maximeprades/drawbox/README.md

# DrawBox

**Say it. Draw it. Print it.**

Your kid presses a big red button, says what they want to draw, and a coloring page prints out in seconds. No screen. No app. Just a button, a voice, and a printer.

<p align="center">
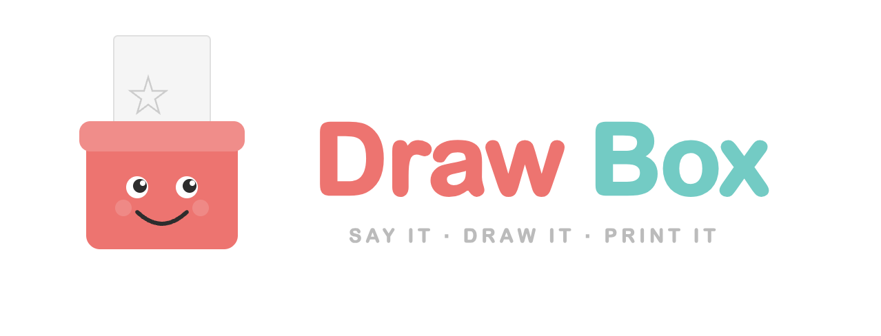
[picture p1: docs/drawbox.jpg]
DrawBox
  
</p>

Built with a Raspberry Pi 5, OpenAI (voice), and your choice of image model — all in a cardboard box with googly eyes.

**~3 hours to build | ~$135 in parts + printer | ~$0.02 per page**

---

## How It Works

```
Kid presses button → "I'm listening!"
    → Kid says "a happy dinosaur with flowers!"
    → Whisper transcribes speech
    → Safety filter checks against word blocklist
    → Image model generates coloring page
    → Pillow converts to clean B&W line art
    → "Here it comes!"
    → Brother laser printer prints it
    → "All done! Press the button when you want another one!"
```

Recording stops on its own about 1.5 seconds after the kid stops talking —
nobody stares at a listening box. While the image generates, DrawBox speaks a
personalized acknowledgment ("Ooh, a happy dinosaur with flowers! Drawing it
now!") and tells jokes to keep them entertained.

### Conversation Mode (beta)

Flip one setting and the boxes hold a real back-and-forth conversation
(Grok Voice Agent): the box chats, asks follow-ups, and prints when it has
heard enough. Drawings still pass the safety filter, spoken admin commands
stay deterministic, and the classic one-shot flow remains the fallback.
Costs ~$0.05/min of chat (xAI); off by default.

### Special Interactions

- **Hold button 5 seconds** — safe reboot ("Rebooting now! See you in a moment.")
- **Press while busy** — "Hold on, I'm still working on your picture!"
- **Blocked content** — "Hmm, I can't draw that. How about something fun like an animal or a rainbow?"
- **"Please" Mode** — optionally require kids to say "please" before each drawing

## Image Models

DrawBox generates images through Vercel AI Gateway. Pick any catalog model
from the dashboard Settings page (`image_model`). The default is
`google/gemini-3.1-flash-image`. Old aliases (`nano-banana`,
`gpt-image`) and ids the Gateway retired (`google/gemini-3.1-flash-image-preview`,
`openai/gpt-image-1`) still resolve to the matching catalog id.

## Parts

| Part | What It Does | ~Price |
|---|---|---|
| [PiShop Raspberry Pi 5 Budget Kit (4GB)](https://www.amazon.com/s?k=PiShop+Raspberry+Pi+5+Budget+Kit+4GB) | Pi + power supply + SD card + case | $75 |
| [Brother HL-L2405W](https://www.brother-usa.com/products/hll2405w) | B&W laser printer, USB | $100 |
| [EG STARTS 100mm Arcade Button](https://www.amazon.com/dp/B01LZMANZ7) | Big red dome button | $10 |
| [CHANGEEK USB Mic](https://www.amazon.com/dp/B0B4MJQ81C) | Gooseneck USB microphone | $10 |
| USB Sound Bar Speaker | USB-powered speaker (Pi 5 has no headphone jack) | $10 |
| [Pi 5 Active Cooler](https://www.amazon.com/s?k=Raspberry+Pi+5+Official+Active+Cooler) | Blower fan + heatsink (recommended) | $5 |
| [UGREEN USB-A to USB-B Cable](https://www.amazon.com/s?k=UGREEN+USB+A+to+USB+B+Printer+Cable) | Connects Pi to printer | $7 |
| [Female Spade Crimp Terminals](https://www.amazon.com/s?k=female+spade+crimp+terminal+4.8mm) | Connects wires to button's 4.8mm spade terminals | $8 |
| [5" Round Ventilation Grille](https://www.amazon.com/s?k=5+inch+round+ventilation+grille) | Speaker grille for the enclosure | $6 |
| Cardboard + hot glue | The enclosure | $5 |

**Also useful:** a [micro HDMI to HDMI adapter](https://www.amazon.com/s?k=UGREEN+Micro+HDMI+to+HDMI) for initial Pi setup with a monitor, and a [USB-C SD card reader](https://www.amazon.com/s?k=uni+SD+card+reader+USB+C) for flashing the SD card.

**Tools:** box cutter, metal ruler, pencil, hot glue gun, wire strippers (for spade terminals).

### Thermal Printer Option

No laser printer? DrawBox can also drive the [M5Stack ATOM Printer](https://docs.m5stack.com/en/guide/hobby_kit/atom_printer/usage) — a little 58mm receipt printer — or any ESC/POS serial thermal printer:

1. Flash `firmware/atom_printer_bridge_wifi` onto the ATOM once (see its README). It replaces the stock firmware with a print-head bridge that works over WiFi (the ATOM joins your network as `drawbox-atom.local`) or plain USB.
2. In the dashboard, switch **Settings → Printer** to the thermal option that matches: WiFi (host + port 9100) or USB serial.

Pages come out as receipt strips and take ~20-30 seconds at 9600 baud — the suspense is free. Keep the printer on its 12V power supply or prints come out faint. Smoke test without DrawBox:

### The Second Box: ESP32 Voice Button

DrawBox also has a pocket-sized sibling: a [Waveshare ESP32-S3-Touch-AMOLED-2.16](https://www.waveshare.com/esp32-s3-touch-amoled-2.16.htm) running `firmware/esp32_amoled_button/`. It shows a big animated emoji face — tap it, say what you want, and the same pipeline prints it. It speaks with the exact same voice, lines, and jokes as the big box (fetched from the dashboard, so editing scripts changes both), blinks while it waits, and mouths along while your kid talks. Setup, pairing, and build instructions live in its README.

```bash
python3 drawbox_escpos.py --port /dev/ttyUSB0
```

## Quick Start

### 1. Open the Build Guide

Open `drawbox-guide.html` in any browser. It's a single self-contained HTML file — 20 steps across 6 phases with embedded code, wiring diagrams, SVG cut templates, and troubleshooting.

### 2. Follow the 20 Steps

| Phase | Steps | What You Do |
|---|---|---|
| Getting Started | 1 | Verify all parts |
| Phase 1 — Pi Setup | 2-4 | Flash SD, SSH in, install dependencies |
| Phase 2 — Printer | 5-6 | Set up CUPS, test print |
| Phase 3 — Software | 7-10 | API key, create scripts, manual test, auto-start service |
| Phase 4 — Hardware | 11-13 | Wire button (GPIO 17), plug in mic & speaker, integration test |
| Phase 5 — Enclosure | 14-17 | Cut panels, build box, finishing touches |
| Phase 6 — Finishing Up | 18-20 | WiFi portability, cost cap, web dashboard |

### 3. Deploy the Web Dashboard

```bash
./deploy-web.sh
```

One command copies everything to the Pi, installs Flask + gunicorn, creates the systemd service, and starts the dashboard at `http://drawbox.local:5000`.

### 4. Run the Health Check

```bash
./check.sh
```

Verifies: internet, API keys, mic, speaker, printer, GPIO, Python deps, script correctness, services, and voice cache.

## What's In This Repo

| File | Description |
|---|---|
| `drawbox_core.py` | Shared logic — API keys, safety filter, image generation, post-processing, printing, analytics |
| `drawbox.py` | Main script — button listener, voice feedback, recording, transcription, joke-telling |
| `drawbox_web.py` | Flask web dashboard — generate from browser, live logs, settings, diagnostics |
| `drawbox-guide.html` | Complete interactive build guide (open in any browser) |
| `drawbox-simulator.html` | Browser simulator — test the full flow without a Pi (needs API keys) |
| `drawbox-hub.html` | Multi-Pi management hub — monitor and configure multiple DrawBoxes |
| `deploy-web.sh` | One-command deploy to Pi via SSH |
| `deploy-tunnel.sh` | One-command Cloudflare Tunnel setup for remote access |
| `check.sh` | Health check — verifies the entire Pi setup |
| `requirements.txt` | Python dependencies |
| `tests/` | pytest suite for the safety filter, settings, and Flask routes (runs on a Mac, no Pi needed: `pip install pytest && pytest tests/`) |

### Code Architecture

```
drawbox_core.py          ← shared: API keys, safety, generation, printing, logging
    ↑               ↑
drawbox.py          drawbox_web.py
(button + voice)    (Flask dashboard)
```

Both `drawbox.py` and `drawbox_web.py` import from `drawbox_core.py`, which centralizes all shared logic. This means bug fixes and model changes only need to happen in one place. See [ARCHITECTURE.md](ARCHITECTURE.md) for the full technical reference.

## Web Dashboard

The dashboard (`drawbox_web.py`) runs on the Pi at `http://drawbox.local:5000` and provides:

- **Overview** — service status, temperature, uptime, usage analytics, popular prompts
- **Generate & Print** — type a description, generate and print from any browser
- **Live Logs** — streaming service logs via SSE (`journalctl -u drawbox -f`)
- **Settings** — coloring prompt, image model, voice + speech-to-text providers, reply style, conversation mode, listening window, API keys
- **Scripts** — customize every voice line and joke DrawBox tells
- **"Please" Mode** — require kids to say "please" to get a drawing
- **Safety Filter** — toggle the word blocklist on/off
- **WiFi Management** — scan and connect to WiFi networks
- **Diagnostics** — printer status, audio devices, disk usage, temperature, error logs
- **Software Update** — pull latest code from GitHub and apply with one click
- **Service Control** — restart/stop/start DrawBox, reboot Pi

The dashboard uses gunicorn (2 workers, 4 threads) as a production WSGI server.

## Voice Lines

DrawBox talks to kids at every step. All lines are pre-generated as MP3s at startup and cached in `~/.drawbox/voice_cache/` for instant playback.

| When | What It Says |
|---|---|
| Ready | "Ready! Press the button and tell me what to draw!" |
| Listening | "I'm listening!" |
| Thinking | "Ooh, great idea!" / "That sounds awesome!" / "Cool!" (random) |
| Printing | "Here it comes!" |
| Done | "All done! Press the button when you want another one!" |
| Blocked | "Hmm, I can't draw that. How about something fun like an animal or a rainbow?" |
| Busy | "Hold on, I'm still working on your picture!" |
| Say please | "Oops! Don't forget to say please!" |
| Reboot | "Rebooting now! See you in a moment." (hold button 5s) |

All voice lines and jokes can be customized from the dashboard's Scripts page.

## Cost

Each coloring page is billed through Vercel AI Gateway (image + TTS + STT).
Set a spend limit on the Gateway dashboard.

## Safety

This is used by young children, so safety is built in at multiple layers:

1. **Word blocklist** — ~100 blocked words covering violence, sexual content, profanity, drugs, horror, and hate speech. Uses word-boundary matching so innocent words like "butterfly" or "grasshopper" are never blocked.
2. **Hardened prompt** — The image generation prompt explicitly instructs safe-only output regardless of what the child says.
3. **Friendly rejection** — "Hmm, I can't draw that. How about something fun like an animal or a rainbow?"
4. **Safety toggle** — Admins can toggle the word filter from the dashboard. Even when off, the AI prompt still requires child-safe output.

## Remote Access (Optional)

Access your DrawBox from anywhere using a Cloudflare Tunnel — no open ports, no dynamic DNS, $0/month on Cloudflare's free tier.

```bash
./deploy-tunnel.sh pi@drawbox.local mybox yourdomain.com
```

This creates:
- `https://mybox.yourdomain.com` — web dashboard (protected by Cloudflare Access)
- `https://mybox-ssh.yourdomain.com` — browser-based SSH terminal

**Prerequisites:** [cloudflared CLI](https://developers.cloudflare.com/cloudflare-one/connections/connect-networks/downloads/) installed on your Mac, logged in (`cloudflared tunnel login`), and a domain on Cloudflare.

After deploying, set up [Cloudflare Access](https://one.dash.cloudflare.com) to protect your tunnel with email OTP or another identity provider.

### Hub Page

`drawbox-hub.html` is a standalone page for monitoring multiple DrawBox Pis from one place. Open it locally or host it on Cloudflare Pages. It shows each Pi's status, temperature, uptime, and lets you toggle settings remotely.

## Troubleshooting

| Problem | Fix |
|---|-----|
| Printer not detected | `lsusb`, try different USB port |
| Mic not recording | `arecord -l` to list devices, check `~/.asoundrc` |
| Says "I didn't catch that" on every press | `journalctl -u drawbox -e`. `no usable input devices found` means the Pi sees no mic: check the cable. Each take logs `recorded …s (peak …)`; speech should peak near 0.15. Far lower means the mic gain is down: see [PI-SETUP step 10](PI-SETUP.md#10-set-the-mic-gain-one-time) |
| Drawing is made but nothing prints | **Settings → Printer Type**: the USB Brother needs **Laser / inkjet (CUPS)**. **M5Stack ATOM thermal — WiFi** works only while the ATOM bridge answers at `drawbox-atom.local` (green LED). `lpstat -p drawbox-printer` says `disabled`: CUPS paused the queue after a job failed while the printer was off. The next press re-enables it; `sudo cupsenable drawbox-printer` does it by hand |
| Says "Drawing it now!" then goes quiet | The image request is stuck. After 100 s it gives up and says "Oops". `journalctl -u drawbox -e` shows the Gateway error |
| No speaker sound | `aplay -l`, check `~/.asoundrc` card numbers |
| Button no response | Test with: `python3 -c "from gpiozero import Button; b=Button(17); print('pressed' if b.is_pressed else 'open')"` |
| Images too dark | Lower threshold from 180 to 150 in `drawbox_core.py` |
| Service won't start | `journalctl -u drawbox -e` — usually wrong API key |
| Dashboard not loading | `sudo systemctl status drawbox-web` |
| Tunnel not connecting | `sudo systemctl status cloudflared` and check `/etc/cloudflared/config.yml` |
| Need to reboot | Hold the big red button for 5 seconds |

## Pi 5 Gotchas

These are already handled in the guide, but good to know:

- **No headphone jack** — must use USB speaker
- **RPi.GPIO doesn't work** — use `gpiozero` instead (Pi 5 uses the RP1 I/O chip)
- **USB mic only supports 44100Hz** — not 16000Hz
- **GPIO chip is `gpiochip4`** — not gpiochip0 like older Pis (`gpiozero` handles this automatically)
- **USB devices shift card numbers** — if plugged into different ports, verify with `aplay -l` and `arecord -l`

## Contributing

See [CONTRIBUTING.md](CONTRIBUTING.md). Bug fixes, build guide improvements, and photos of your build are all welcome.

## License

[MIT](LICENSE)

---

## Photos

<p align="center">
DrawBox — front view with button, mic, and label
  
DrawBox — giant googly eyes
  
  
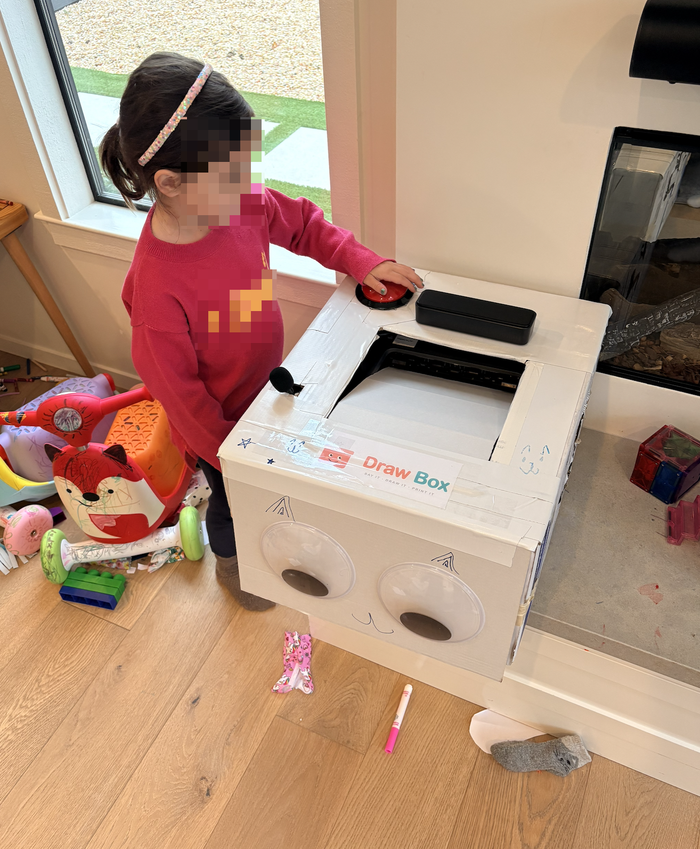
[picture p4: docs/1.jpeg]
Kid using DrawBox
  
</p>

---

Built for my kids. Now yours can have one too.
