maximeprades/drawbox/firmware/esp32_amoled_button/README.md

# DrawBox voice button (ESP32-S3 AMOLED)

A one-button DrawBox remote for the Waveshare **ESP32-S3-Touch-AMOLED-2.16**
(480×480 touch AMOLED, dual mics). Tap the big button, say what you want
("draw me a dinosaur"), and the page prints. The box records a 16 kHz WAV
and POSTs it to the Pi dashboard's `/api/voice/generate`; Whisper, the
safety filter, image generation, and printing all stay on the Pi.

With the dashboard's **conversation mode** on, a tap opens a live Grok
Voice Agent session instead (see [Conversation mode](#conversation-mode)):
the box streams the mics to the Vercel AI Gateway, plays the agent's
voice back, and the agent decides when you are done talking.

The screen is a big emoji buddy rendered with LVGL 8.4: it blinks and
glances around while idle, goes wide-eyed with its mouth moving to your
voice while listening (progress ring, rippling sound waves), naps under
a spinner while the Pi draws, and shows a joyful or deadpan face with
the transcript for the result. The face itself is pre-rendered on the
host by `gen_face_assets.py` (Pillow, 3x supersampled) into anti-aliased
bitmap frames baked into flash — nothing hand-drawn at runtime, so there
are no vector artifacts. `build.sh` regenerates `face_assets.h` when the
generator changes; the header is gitignored (4+ MB of hex).

## Setup

1. Copy `wifi_credentials.h.example` to `wifi_credentials.h` and fill in
   WiFi (2.4 GHz only), the DrawBox host, and a device token. The file is
   gitignored — never commit it.
2. Mint the token (physical route: press the arcade button, say
   "authorize"; or over SSH):

```bash
CODE=$(ssh pi@drawbox.local "cd /home/pi && python3 -c \
    'import drawbox_core; print(drawbox_core.open_pairing_window())'")
curl -X POST http://drawbox.local:5000/api/pair \
    -H 'Content-Type: application/json' \
    -d "{\"code\":\"$CODE\",\"name\":\"ESP32 voice button\"}"
```

3. Build and flash (needs `arduino-cli` with the `esp32:esp32` core):

```bash
./build.sh flash /dev/cu.usbmodemXXXX
```

`build.sh` fetches the display/touch/sensor/LVGL libraries from
Waveshare's own board repo, pinned to a known commit, into the gitignored
`.libs/`, then overlays our `lv_conf.h` (vendor config plus
`LV_USE_SNAPSHOT` for the screenshot hook). Asset generation needs
`python3` with Pillow. The ES7210 mic driver is vendored here (Espressif
MIT), with one behavioral change from the vendor example: gain goes to
MIC1/MIC2 — the board's real microphones per the schematic — not the
MIC3/4 echo-cancellation loopback the example boosts. With the example's
gains the recordings are silence.

## Serial test hooks

The native USB port doubles as a console at 115200:

- `t` — simulate a button press (full record → upload → result cycle, or
  a conversation session when the mode is on)
- `d` — dump the last recording as base64 WAV between marker lines
- `p` — dump a screenshot of the live UI as base64 RGB565 (little-endian)
- `b` — speaker loopback self-test (plays a tone, reports the mic peak)
- `s` — one-line status (state, WiFi, IP, heap, PSRAM, last WAV size,
  version, volume, brightness, conversation mode); also works mid-session
- `x` — end the running conversation session (same as the long press)
- `w` — conversation-mode heap spike: opens a TLS websocket to the Vercel
  AI Gateway realtime route next to the live UI and prints heap at each
  step (see `realtime_spike.h`). A 401 "Invalid client secret" after
  "wss connected" is the expected answer to the probe's bogus token.

A full remote test from the Mac, no hands needed:

```bash
(sleep 3 && say "draw me a dinosaur") & \
    python3 dbx_serial.py /dev/cu.usbmodemXXXX 45 t 1
```

## Sound

The onboard ES8311 codec drives the little speaker on the same I2S bus
as the mics (full duplex). After WiFi comes up, the box fetches the
dashboard voice catalog from `GET /api/voice/lines` and prefetches each
line as 16 kHz mono WAV from `GET /api/voice/line?key=&i=`. Clips live
in PSRAM. Each heartbeat reply carries the server's voice cache hash;
when the scripts or the TTS voice change in the dashboard, the box drops
its cache and refetches within a minute. The spoken lines and jokes are
the same ones the Pi arcade box uses, same voice included.

State changes play the matching line (`ready`, `listening`, `thinking`,
`printing`, or the `voice_key` from `/api/voice/generate`). While the
generate request is in flight, the box tells one joke after about two
seconds if the catalog has any. Synthesized chirps stay as the fallback
when a line is missing from the cache.

The listen line finishes before the mic opens, so recordings never
contain it. Upstream quirk worth knowing: the DAC power-up hides inside
`es8311_microphone_config`, so that call is required even though we
never use the ES8311's own mic path.

## Conversation mode

`realtime_client.h` is the ESP32 half of DrawBox conversation mode — the
same live Grok Voice Agent session the Pi runs in `drawbox_realtime.py`,
with the same policy, so both boxes behave alike:

1. Each heartbeat reply carries `conversation_mode`. When it is on, a tap
   POSTs `/api/realtime/token` and gets back the Gateway WSS URL, a
   ready-made `Sec-WebSocket-Protocol` header holding a 5-minute client
   secret, and the shared session config (instructions, voice, the
   `draw_coloring_page` tool, server VAD). The long-lived Gateway key
   never reaches the box.
2. The box opens the socket (TLS pinned to the Let's Encrypt roots in
   `gateway_ca.h`), sends `session-update`, and streams the mics as
   `input-audio-append` events: 16 kHz capture, louder mic slot kept,
   resampled to the agent's 24 kHz, base64, one event per 60 ms.
3. `audio-delta` events come back as 24 kHz PCM, get resampled to 16 kHz
   and queued in a PSRAM ring that the loop drains into the I2S DMA
   without blocking. The mouth moves with the agent's voice; the eyes go
   wide while the kid talks (`speech-started`).
4. Every `input-transcription-completed` goes to `POST /api/agent/intercept`
   (admin commands and blocklist, on the Pi). The agent's streamed
   transcript goes to `POST /api/agent/moderate` at most once a second
   and once more at `response-done`. A hit cancels the response, drops
   the queued audio, speaks the server's line (dynamic clip by `ack_key`,
   else the cached `voice_key`), and counts a strike; two strikes end the
   session.
5. `function-call-arguments-done` for `draw_coloring_page` is forwarded
   to `POST /api/agent/draw` (the gated pipeline; generation runs on the
   Pi) and the reply goes back as a `function-call-output` item followed
   by `response-create`.
6. The session ends after 45 s without kid speech, at the server's
   `max_session_s` cap, on two strikes, on a long press ("hold to stop"),
   or when the socket drops (the box then speaks the error line). If no
   session ever got configured — mode just switched off, Pi unreachable,
   Gateway refused, config rejected — the tap falls back to the one-shot
   record → upload flow, exactly like the Pi.

No barge-in: speaker and mics share one small box with no echo
cancellation, so mic frames are dropped while the agent's audio plays
(and for 700 ms after — the TX DMA holds ~380 ms). Talk when it stops.

## Behavior notes

- Recording stops early ~1.5 s after the kid stops talking (peak-based
  VAD, same thresholds as the Pi box); the dashboard's `record_seconds`
  setting is the ceiling (fetched once at boot, then refreshed on each
  heartbeat; defaults to 8 s if the first fetch fails).
- Since v1.6.0 the upload uses the two-phase ack flow: the server answers
  as soon as the transcript clears the gates with a personalized ack clip
  (played immediately), then the box long-polls `/api/voice/result` for
  the outcome, telling a joke while it waits. Old servers (no `job` field)
  are parsed exactly like the legacy blocking flow.
- Every 60 s the box POSTs a heartbeat to `/api/device/heartbeat`
  (`version`, WiFi RSSI, heap, PSRAM, voice-cache state). The dashboard
  Devices panel shows that status. The reply carries the live knobs
  (volume, brightness, `record_seconds`, `conversation_mode`, voice cache
  hash); a conversation session keeps beating every minute too.
- Speaker volume and screen brightness follow Settings → ESP32 Box. Each
  heartbeat applies the live values.
- Both mics are captured; the louder channel is kept, so covering one mic
  doesn't mute the box.
- Responses show the dashboard's own script lines ("Here it comes!",
  "Hmm, I can't draw that..."), so both boxes share one personality.
- One request at a time: if the other box is mid-generation the server
  answers busy and the screen says so.
