maximeprades/drawbox/ARCHITECTURE.md

# Architecture

Technical reference for DrawBox internals. Read this if you want to understand how the system works, contribute, or build your own variant.

## How It Works

1. Kid presses the big red arcade button
2. Speaker says "I'm listening!"
3. Kid says what they want ("a dinosaur riding a skateboard")
4. Whisper transcribes the audio
5. Safety filter checks for inappropriate content (~100-word blocklist)
6. GPT Image generates a coloring page (black & white line drawing)
7. Speaker announces "Here it comes!"
8. Brother laser printer prints it
9. Speaker says "All done! Press the button when you want another one!"

Special interactions:
- **Hold button 5 seconds** — safe reboot ("Rebooting now! See you in a moment.")
- **Press while busy** — "Hold on, I'm still working on your picture!"
- **Blocked content** — "Hmm, I can't draw that. How about something fun like an animal or a rainbow?"

## Hardware

| Component | Exact Model | Connection | Notes |
|---|---|---|---|
| **Computer** | Raspberry Pi 5 (4GB) | — | Running Raspberry Pi OS Bookworm (64-bit Lite) |
| **Printer** | Brother HL-L2405W | USB | Mono laser, set up driverless via IPP |
| **Button** | EG STARTS 100mm arcade button | GPIO 17 (Pin 11) + GND (Pin 9) | Microswitch has 4.8mm spade terminals |
| **Microphone** | CHANGEEK USB mic | USB (card 2, hw:2,0) | Only supports 44100Hz sample rate |
| **Speaker** | USB speaker | USB (card 3) | Configured as default via ~/.asoundrc |
| **Power** | Official Pi 5 27W USB-C PSU | USB-C | — |
| **Storage** | 32GB microSD | SD slot | — |

### Critical Hardware Notes

1. **RPi.GPIO does NOT work on Pi 5** — Must use `gpiozero`. The Pi 5 uses a different I/O chip (RP1) that RPi.GPIO doesn't support.
2. **USB mic sample rate is 44100Hz** — NOT 16000Hz. Using wrong rate causes `PortAudioError: Invalid sample rate`.
3. **GPIO chip on Pi 5 is `gpiochip4`** — Not gpiochip0 like older Pis. gpiozero handles this automatically.
4. **Button wiring**: COM → Pin 11 (GPIO 17), NO → Pin 9 (GND). The tab with the 90-degree bend is COM.
5. **No headphone jack on Pi 5** — Must use USB speaker or Bluetooth.
6. **USB devices shift card numbers** — If plugged into different ports, card numbers change. Verify with `aplay -l` and `arecord -l`.

### GPIO Pinout

```
Pin 9  (GND)     ← Button NO terminal
Pin 11 (GPIO 17) ← Button COM terminal
```

## Software Stack

| Layer | Technology | Notes |
|---|---|---|
| OS | Raspberry Pi OS Bookworm 64-bit Lite | Headless, no desktop |
| Language | Python 3 | System Python, no virtualenv |
| GPIO | gpiozero | NOT RPi.GPIO (incompatible with Pi 5) |
| AI - Image | Vercel AI Gateway | catalog id from `GATEWAY_IMAGE_CATALOG` |
| AI - Speech-to-Text | Vercel AI Gateway (`openai/whisper-1` or `spacexai/grok-stt`) | Selected by the `stt_provider` setting |
| AI - Text-to-Speech | Vercel AI Gateway (`openai/tts-1` or `spacexai/grok-tts`) | Selected by the `voice_provider` setting; gateway voice `alloy` is the default |
| AI - Conversation | Vercel AI Gateway realtime (`spacexai/grok-voice-think-fast-2.0`) | Opt-in `conversation_mode`; normalized AI SDK realtime events over `wss://ai-gateway.vercel.sh/v4/ai/realtime-model` |
| Audio Recording | sounddevice + soundfile | Via PortAudio/ALSA |
| Image Processing | Pillow (PIL) | Threshold + resize to Letter |
| Audio Playback | mpg123 | Plays cached .mp3 TTS files |
| Printing | CUPS (lp command) | Driverless IPP setup |
| Web Dashboard | Flask | `http://drawbox.local:5000` |
| Process Management | systemd | Two services: `drawbox.service` + `drawbox-web.service` |

### Python Dependencies

```
openai, Pillow, numpy, sounddevice, soundfile, gpiozero, flask, websockets
```

## Script Architecture (drawbox.py)

### Flow

```
main()
  └→ button.wait_for_press()
       ├→ [if held >= 5s] → voice.play("reboot") → sudo reboot
       ├→ [if is_busy] → voice.play("busy") → continue
       └→ [normal press]:
            └→ voice.play("listening")
            └→ record_audio()          # record_seconds setting (default 10s) at 44100Hz
            └→ transcribe()            # Whisper API
            └→ is_safe()               # Blocklist check
            └→ voice.play("thinking")  # Random variation (5 options)
            └→ generate_image()        # AI Gateway image model
            └→ voice.play("printing")
            └→ print_image()           # lp command to CUPS
            └→ voice.play("done")
```

### Key Design Decisions

1. **gpiozero Button** with `pull_up=True, bounce_time=0.1` — `wait_for_press()` blocks until button pressed, bounce_time prevents double-triggers
2. **Long-press reboot** — Polls `btn.is_pressed` in 0.1s increments; if held >= 5 seconds, plays "Rebooting now!" and runs `sudo reboot`
3. **VoiceFeedback class** — Pre-generates and caches all TTS lines as .mp3 at startup (`~/.drawbox/voice_cache/`). Uses MD5 hash of voice+text for deterministic filenames. 0.5s sleep before playback lets USB speaker wake up.
4. **if/elif/else chain** (not try/continue) — Avoids `continue` inside `try/finally` blocks which would skip `is_busy = False` reset.
5. **Walrus operator** for transcription: `elif not (text := transcribe(path)) or len(text.strip()) < 2`
6. **Safety blocklist** — Set of ~100 blocked words checked against transcription. Plus prompt engineering in COLORING_PROMPT.
7. **Image post-processing** — Convert to grayscale → threshold at 180 → resize to 1125x1125 → paste centered on 1275x1650 Letter canvas
8. **Busy guard** — `is_busy` flag prevents overlapping requests
9. **Minimum audio check** — Recordings shorter than 0.5s are discarded (silence/accidental press)

## Web Dashboard (drawbox_web.py)

Flask web app at `http://drawbox.local:5000`. Runs as a separate systemd service.

### Routes

| Route | Method | Purpose |
|---|---|---|
| `/` | GET | Dashboard (single-page, inline HTML) |
| `/guide` | GET | Serves drawbox-guide.html |
| `/simulator` | GET | Serves drawbox-simulator.html |
| `/api/generate` | POST | Safety check → generate image → print |
| `/api/voice/generate` | POST | Raw WAV body → STT → same gates/pipeline as `/api/generate`; responses carry a `voice_key` naming the script line to speak. With `X-DrawBox-Ack: 1` (firmware >= 1.6.0) it answers right after the gates with a personalized `ack_key` clip while generation continues server-side |
| `/api/voice/result` | GET | Long-poll the in-flight voice job (`?id=`) for the final outcome |
| `/api/voice/clip` | GET | One synthesized 16 kHz WAV by cache key (`?k=`) — ack and intercept clips |
| `/api/voice/lines` | GET | Voice-line manifest: variant counts per script key, joke count, cache hash |
| `/api/voice/line` | GET | One script line or joke (`?key=K&i=N`) as 16 kHz mono WAV, disk-cached beside the daemon's mp3 cache |
| `/api/realtime/token` | POST | Conversation mode: ephemeral xAI client secret + the shared session config |
| `/api/agent/draw` | POST | Conversation mode: execute the agent's gated draw tool call |
| `/api/agent/intercept` | POST | Conversation mode: run a transcript through the admin/blocklist interceptor |
| `/api/logs` | GET | SSE stream of journalctl |
| `/api/settings` | GET/POST | Read/write settings |
| `/api/diagnostics` | POST | Run allowlisted diagnostic commands |
| `/api/service/<action>` | POST | systemctl restart/stop/start |
| `/api/status` | GET | Service status, temperature, uptime |
| `/api/reboot` | POST | sudo reboot |

### Implementation Notes

- **Shared core** — Both scripts import from `drawbox_core.py` (API keys, safety, image generation, printing, logging)
- **No auth** — Home toy on local network
- **Diagnostics allowlist** — 14 commands, no arbitrary shell execution
- **Log streaming** — SSE via `journalctl -u drawbox -f`

## File Layout

### Development (Mac)

```
drawbox_core.py         # Shared logic (API keys, safety, generation, printing)
drawbox.py              # Main script (the brain)
drawbox_web.py          # Flask web dashboard
drawbox-guide.html      # 20-step interactive build guide
drawbox-simulator.html  # Browser-based simulator (no Pi needed)
deploy-web.sh           # One-command deploy to Pi
check.sh                # Health check script
requirements.txt        # Python dependencies
```

### Pi (/home/pi/)

```
~/drawbox_core.py         # Shared logic module
~/drawbox.py              # Main script (drawbox.service)
~/drawbox_web.py          # Web dashboard (drawbox-web.service)
~/drawbox-guide.html      # Served at /guide
~/drawbox-simulator.html  # Served at /simulator
~/check.sh                # Health check
~/.drawbox/voice_cache/   # Cached TTS audio (.mp3)
~/.drawbox/web_settings.json  # Dashboard settings
~/.asoundrc               # ALSA audio device config
```

### Systemd Services

```
/etc/systemd/system/drawbox.service      # Main script, auto-starts on boot
/etc/systemd/system/drawbox-web.service  # Dashboard, auto-starts on boot
/etc/sudoers.d/drawbox-web               # Passwordless systemctl for dashboard
```

## Configuration

### API Keys

DrawBox loads API keys with this precedence (first match wins per key):

1. `~/.drawbox/api_keys.json` field `ai_gateway`
   (mode 0600, managed from the dashboard)
2. Environment variable `AI_GATEWAY_API_KEY`

The OpenAI Python client talks to `https://ai-gateway.vercel.sh/v1` for
images. Speech, transcription, and conversation-mode realtime also go
through the AI Gateway (OpenAI or xAI models, one key). The dashboard
writes the JSON file; `deploy-web.sh` migrates an existing systemd
`AI_GATEWAY_API_KEY` into it on first run. New deployments don't need keys
in the service file at all.

### Optional Environment Variables

| Variable | Effect |
|---|---|
| `IMAGE_MODEL` | Default model — a gateway catalog id (see `GATEWAY_IMAGE_CATALOG`). Legacy aliases such as `nano-banana` rewrite to the matching catalog id. |
| `DRAWBOX_ALLOWED_ORIGINS` | Comma-separated CORS allowlist for the dashboard. Defaults cover `*.drawbox.pages.dev`. Accepts exact hosts or `*.domain.tld` patterns. |

### ALSA Audio (~/.asoundrc)

```
defaults.pcm.card 3
defaults.ctl.card 3
```

Card numbers depend on USB port order. Verify with `aplay -l` and `arecord -l`.

### Printer Setup

```bash
# Driverless IPP (recommended)
sudo lpadmin -p drawbox-printer -E \
    -v "ipp://Brother%20HL-L2405W%20(USB)._ipp._tcp.local/" \
    -m everywhere
sudo lpoptions -d drawbox-printer
```

For the M5Stack ATOM Printer (or any ESC/POS serial thermal printer), CUPS
is not involved. `print_image()` hands the page to `drawbox_escpos.py`,
which renders it to ESC/POS raster bytes and writes them to the printer.
The ATOM must be flashed once with the bridge sketch in
`firmware/atom_printer_bridge_wifi/` (see its README).

Two transports, chosen by `printer_type` in the dashboard Settings (stored
in `~/.drawbox/web_settings.json`): `escpos_tcp` prints over the network —
the flashed ATOM joins your WiFi, announces itself as `drawbox-atom.local`,
and accepts one raw TCP client on port 9100 (`tcp_host` / `tcp_port`) —
and `escpos_serial` prints over a USB cable (`serial_port` /
`serial_baud`). Same rendering path either way.

### ESP32 voice button (second box)

A standalone voice box on a Waveshare ESP32-S3-Touch-AMOLED-2.16
(`firmware/esp32_amoled_button/`). The screen is an animated emoji face
(LVGL + host-prerendered bitmaps); tapping it records 16 kHz WAV from the
onboard mics and POSTs it to the dashboard's `/api/voice/generate` with a
paired-device token. Transcription, safety, generation, and printing all
run on the Pi, so the firmware stays a thin record-and-upload client.

It speaks with the Pi box's exact personality: at boot it prefetches every
dashboard voice line (and jokes on demand) from `/api/voice/lines` +
`/api/voice/line` into PSRAM and plays them through its ES8311 codec at
the same moments the button daemon speaks — ready, listening, a thinking
variant, one joke while generating, and the `voice_key` line the server
names in each response. Editing scripts or the TTS voice in the dashboard
changes both boxes; the box re-fetches at boot and, via the cache hash in
each heartbeat reply, within a minute of an edit. Synthesized chirps
remain only as a fallback when a line is missing.

### Conversation mode (opt-in)

With the `conversation_mode` setting on, a press/tap starts a live Grok
Voice Agent session (`drawbox_realtime.py` on the Pi,
`firmware/esp32_amoled_button/realtime_client.h` on the ESP32). The session
config — voice, editable `agent_instructions`, server VAD, the
`draw_coloring_page` tool — is built once in
`drawbox_core.realtime_session_config()` so both boxes share one personality. The wire protocol is the AI SDK's normalized
realtime event set (`session-update`, `input-audio-append`, `audio-delta`,
`input-transcription-completed`, `function-call-arguments-done`, ...); the
Gateway translates to xAI server-side. Auth is a short-lived `vcst_`
client secret minted by `mint_realtime_client_secret()` (TTL 300 s) and
carried in the `Sec-WebSocket-Protocol` handshake as `ai-gateway-auth.<token>`
(`gateway_realtime_protocols()`), never as an `Authorization` header —
`POST /api/realtime/token` hands the ESP32 the URL, token, and protocol
list ready-made (plus `protocol_header`, the list pre-joined). Safety is
layered: the agent's tool calls run the full gates (`execute_draw_tool`),
and every input/output transcript passes the deterministic
`intercept_transcript` (exact-match admin commands, then the blocklist)
with response-kill on a hit; two strikes end the session. The Pi calls
those core functions directly; the ESP32 reaches the same code over
`POST /api/agent/intercept` (kid transcripts), `POST /api/agent/moderate`
(the agent's words — blocklist only, never the admin commands) and
`POST /api/agent/draw`, and learns whether the mode is on from the
`conversation_mode` flag in every heartbeat reply. The box has no echo
cancellation, so it mutes its mics while the agent's audio plays (no
barge-in); the Pi, with separate USB mic and speaker, streams
continuously. Sessions cost $0.08/min of audio (xAI's rate, passed through
by the Gateway; the Gateway itself also caps sessions at 25 min and idles
them out at 5), cap at 5 minutes client-side,
and any failure falls back to the one-shot flow. See the firmware README
for setup, build, and the serial test hooks.

## Known Issues

| Issue | Cause | Fix |
|---|---|---|
| SSH dies after reboot | Socket not enabled | `sudo systemctl enable ssh.service && sudo systemctl enable ssh.socket` |
| "GPIO busy" error | Previous process holds pin | `sudo killall python3` then restart service |
| `continue` in try/finally | `is_busy` flag stays stuck | Use if/elif/else chains instead (already fixed) |
| drawbox.local not resolving | mDNS issue | Use IP directly: `hostname -I` |
