maximeprades/drawbox/drawbox-guide.html

☰ Guide

# DrawBox Build Guide

Your kid presses a big red button, tells the box what they want to draw, and a coloring page prints out. Magic in a box.

~3 hrsTotal build

20Steps

$0.06Per page

Build Progress0 / 17

📦

## Parts Inventory

Confirm everything before you start

✓

Unbox & verify all parts

5 min▼

Lay everything out. Here's your exact kit:

🖥️ Raspberry Pi 5 (4GB)The brain. Runs the whole show.

✓ You have this

💾 Micro SD Card + USB-C PSUPi's hard drive + 27W power supply

✓ You have this

🖨️ Brother HL-L2405WB&W laser, USB + WiFi. 14"×14"×7.2"

✓ Ordered

🔴 EG STARTS 100mm Arcade ButtonBig red dome, LED, microswitch. 100mm diameter!

✓ Ordered

🎙️ C G CHANGEEK Gooseneck USB MicFlexible gooseneck, built-in sound card, USB-A

✓ Ordered

🔊 USB SpeakerUSB-powered, plug-and-play. No 3.5mm needed (Pi 5 has no headphone jack!)

✓ Ordered

🔌 USB-A to USB-B CableConnects Pi to printer (square end → printer)

✓ Ordered

📦 Golden State Art Cardboard (10pk)24×36" corrugated, one-side white. No wrapping needed!

✓ Ordered

⚠️

Jumper wires: The EG STARTS 100mm button usually comes with wires and a microswitch connector. Check the package. If it only has bare terminals, you need 2 female-to-female dupont jumper wires (~$3 on Amazon).

🔧

Tools needed: Box cutter, metal ruler, pencil, hot glue gun + sticks, something to trace the 100mm circle (coffee mug or compass).

🖥️

## Phase 1 — Raspberry Pi Setup

From sealed box to running computer

✓

Flash the SD card with Raspberry Pi OS

10 min▼

On your Mac or PC:

1. Download Raspberry Pi Imager from raspberrypi.com/software

2. Insert your micro SD card (use adapter if needed)

3. Open Imager and select:

settingsDevice: Raspberry Pi 5 OS: Raspberry Pi OS Lite (64-bit) → Under "Raspberry Pi OS (other)" → Lite version Storage: Your SD card

4. Click the gear icon ⚙️ (OS Customization) — this is the key step:

customization☑ Set hostname: drawbox ☑ Enable SSH: Use password authentication ☑ Set username: pi ☑ Set password: your-password-here ← remember this! ☑ Configure WiFi: SSID: your-wifi-name Password: your-wifi-password Country: US ☑ Set locale: Timezone: America/New_York Keyboard: us

5. Click Write. Wait 5-10 minutes.

💡

Setting WiFi + SSH here means you never need a monitor, keyboard, or mouse on the Pi. You'll control it entirely from your laptop. This is called "headless" setup.

▶️

Video guide: Search: Raspberry Pi Imager headless setup (https://www.youtube.com/results?search_query=raspberry+pi+imager+headless+setup+ssh+wifi) — watch someone walk through each screen.

✓

First boot & SSH into the Pi

5 min▼

Assemble:

1. Insert flashed SD card into Pi (bottom slot, push until click)

2. Plug USB-C power supply in

3. That's it — green LED flickers as it boots

⏳

Wait 60-90 seconds on first boot. It needs to expand filesystem, connect WiFi, start SSH.

Connect from your laptop terminal:

terminalssh pi@drawbox.local

Type yes for fingerprint, then your password.

If drawbox.local doesn't work:

terminal# Check your router's admin page for the Pi's IP # Or try: ping drawbox.local # Then: ssh pi@[IP_ADDRESS]

When you see pi@drawbox:~ $ — you're in! 🎉

💡

From now on, every command in this guide is typed into this SSH terminal.

⚠️

SSH may die after reboot. Pi OS sometimes only enables ssh.socket but not ssh.service. To make SSH reliable, run:
sudo systemctl enable ssh.socket && sudo systemctl enable ssh.service

✓

Install all software dependencies

10 min▼

Run these one at a time in SSH:

A — Update system:

bashsudo apt update && sudo apt upgrade -y

Takes 3-5 min. Let it run.

B — System packages:

bashsudo apt install -y cups printer-driver-brlaser python3-pip \ libportaudio2 libsndfile1 alsa-utils mpg123

C — Python packages:

bashpip3 install --break-system-packages \ openai gpiozero sounddevice soundfile numpy Pillow

ℹ️

What these do: cups = print system, printer-driver-brlaser = Brother driver, mpg123 = plays TTS audio, openai = GPT Image + Whisper + TTS API, gpiozero = button input, sounddevice = mic recording, Pillow = image processing

🖨️

## Phase 2 — Printer Setup

Brother HL-L2405W via USB

✓

Connect printer & configure CUPS

10 min▼

Physical setup:

1. Unbox Brother, remove all packing tape/inserts

2. Install toner cartridge (in box, wrapped in plastic)

3. Load Letter paper (8.5×11) in tray

4. Plug in power, turn on

5. USB-A end → Pi, USB-B end → back of printer

⚠️

Wait for printer to finish calibration (~30 sec). Ready light should be solid green.

Configure CUPS:

bash# Add user to printer admin group sudo usermod -aG lpadmin pi # Start print system sudo systemctl enable cups sudo systemctl start cups # Verify Pi sees printer via USB lsusb # Should show: "Brother Industries, Ltd" # List available printers lpinfo -v # Look for: direct usb://Brother/HL-L2405W...

Add the printer:

bash# Add using driverless (IPP Everywhere) — works on Pi OS Bookworm sudo lpadmin -p drawbox-printer -E \ -v "$(lpinfo -v 2>/dev/null | grep -i brother | head -1 | awk '{print $2}')" \ -m everywhere # If driverless fails, try brlaser driver: # sudo lpadmin -p drawbox-printer -E \ # -v "$(lpinfo -v | grep -i brother | head -1 | awk '{print $2}')" \ # -m drv:///brlaser.drv/brl2405w.ppd # Set as default sudo lpoptions -d drawbox-printer sudo cupsenable drawbox-printer sudo cupsaccept drawbox-printer

ℹ️

Printer sleep mode: The Brother HL-L2405W goes to sleep after a few minutes of inactivity. Print jobs queue up and will print automatically when the printer wakes — just takes a few extra seconds for the first print.

💡

Web UI option: Run sudo cupsctl --remote-admin, then open http://drawbox.local:631 in your browser → Administration → Add Printer.

▶️

Video guide: Search: Raspberry Pi CUPS USB printer setup (https://www.youtube.com/results?search_query=raspberry+pi+cups+usb+printer+setup)

✓

Send a test print

2 min▼

bashecho "DrawBox test - $(date)" | lp -d drawbox-printer lpstat -p -d

A page should print. If it does — printer is working! 🎉

🔧

Nothing printed? lpstat -p (is it listed?), lsusb (Brother showing?), try replugging USB, check sudo tail /var/log/cups/error_log

💻

## Phase 3 — Software

Speech → Image → Print pipeline

✓

Set up OpenAI API key

3 min▼

You likely have one already. If not: platform.openai.com → API Keys → Create new key → name it "DrawBox"

bash# Save to shell profile echo 'export OPENAI_API_KEY="sk-your-key-here"' >> ~/.bashrc source ~/.bashrc # Verify echo $OPENAI_API_KEY

💰

Cost: ~$0.04/image (GPT Image) + ~$0.006/min (Whisper) + ~$0.01 (TTS voice) = ~$0.06 per coloring page. $5 = ~80 pages.

✓

Create the DrawBox script

5 min▼

This is the entire app — one Python file:

bashnano ~/drawbox.py

Paste the script below. In nano: right-click to paste, Ctrl+O to save, Ctrl+X to exit.

✏️

Customize: Edit the coloring prompt below. Your changes will be included in the script.

Coloring Prompt — edit to customize Create a simple coloring page for children ages 3-8. This is used by YOUNG CHILDREN — output MUST be 100% child-safe. - Black and white LINE DRAWING only - Thick, clean outlines (3-4px stroke) - NO shading, NO gradients, NO filled/solid areas - NO gray — pure black lines on white - Simple shapes, minimal fine detail - Large open areas for coloring with crayons - Friendly, fun, cute, non-scary style - Centered, filling most of the space - Style: children's coloring book page - ONLY draw safe, wholesome subjects (animals, nature, vehicles, food, toys) - NEVER draw anything violent, scary, sexual, or inappropriate for a 5-year-old - If the request is ambiguous, default to the most innocent interpretation

Copy Prompt Reset Default

drawbox.py

#!/usr/bin/env python3
"""DrawBox — AI Coloring Page Printer for Kids

Hardware: Pi 5, Brother HL-L2405W (USB), EG STARTS 100mm button,
          CHANGEEK USB mic, USB speaker
"""

import os, time, tempfile, subprocess, random, hashlib, threading
import sounddevice as sd
import soundfile as sf
import numpy as np
from gpiozero import Button as GpioButton
from openai import OpenAI
from PIL import Image
import base64
from io import BytesIO
from pathlib import Path

# ── CONFIG ──────────────────────────────────────
OPENAI_API_KEY = os.environ.get("OPENAI_API_KEY")
BUTTON_PIN = 17
SAMPLE_RATE = 44100
PRINTER_NAME = "drawbox-printer"
RECORD_SECONDS = 10
REBOOT_HOLD_SEC = 5           # hold button 5s to reboot
TTS_VOICE = "nova"            # alloy, echo, fable, onyx, nova, shimmer
CACHE_DIR = Path.home() / ".drawbox" / "voice_cache"

# ── SAFETY BLOCKLIST ────────────────────────────
BLOCKED_WORDS = {
    "kill", "murder", "dead", "death", "die", "dying", "corpse",
    "blood", "bloody", "gore", "gory", "wound", "stab", "shoot",
    "gun", "guns", "rifle", "pistol", "shotgun", "weapon", "knife",
    "bomb", "explode", "explosion", "grenade", "missile", "nuke",
    "sex", "sexy", "sexual", "nude", "naked", "porn", "hentai",
    "penis", "dick", "cock", "vagina", "pussy", "boob", "breast",
    "nipple", "butt", "ass", "anus", "genital", "erotic", "orgasm",
    "fuck", "shit", "damn", "bitch", "bastard", "crap", "piss",
    "whore", "slut", "hooker", "prostitute", "stripper",
    "drug", "drugs", "cocaine", "heroin", "meth", "weed", "marijuana",
    "alcohol", "beer", "wine", "vodka", "drunk", "cigarette", "smoke",
    "devil", "satan", "demon", "hell", "torture", "horror", "zombie",
    "vampire", "skeleton", "skull", "coffin", "grave", "creepy",
    "scary", "nightmare", "terror", "evil", "wicked", "curse",
    "hate", "racist", "racism", "nazi", "hitler", "slavery", "slave",
    "suicide", "hanging", "noose", "drown", "poison", "overdose",
    "rape", "molest", "abuse", "kidnap", "assault", "victim",
    "war", "soldier", "army", "military", "combat", "battle",
    "thong", "lingerie", "bikini", "underwear",
    "pee", "fart", "vomit", "snot",
}

def is_safe(text):
    words = text.lower()
    return not any(w in words for w in BLOCKED_WORDS)

COLORING_PROMPT = """Create a simple coloring page for children ages 3-8.
This is used by YOUNG CHILDREN — output MUST be 100% child-safe.
- Black and white LINE DRAWING only
- Thick, clean outlines (3-4px stroke)
- NO shading, NO gradients, NO filled/solid areas
- NO gray — pure black lines on white
- Simple shapes, minimal fine detail
- Large open areas for coloring with crayons
- Friendly, fun, cute, non-scary style
- Centered, filling most of the space
- Style: children's coloring book page
- ONLY draw safe, wholesome subjects (animals, nature, vehicles, food, toys)
- NEVER draw anything violent, scary, sexual, or inappropriate for a 5-year-old
- If the request is ambiguous, default to the most innocent interpretation"""

client = OpenAI(api_key=OPENAI_API_KEY)

# ── VOICE FEEDBACK ─────────────────────────────
# All voice lines. Keys with lists pick randomly.
VOICE_LINES = {
    "ready":     "Ready! Press the button and tell me what to draw!",
    "listening": "I'm listening!",
    "thinking":  [
        "Ooh, great idea! Let me draw that for you!",
        "That sounds awesome! Drawing it now!",
        "Cool! Give me a moment...",
        "Love it! One coloring page coming right up!",
        "Nice choice! Let me work on that!",
    ],
    "printing":  "Here it comes!",
    "done":      "All done! Press the button when you want another one!",
    "error":     "Oops, something went wrong. Try again!",
    "too_short": ("I didn't catch that. Press the button "
                  "and tell me what you want to draw!"),
    "busy":      ("Hold on, I'm still working on your picture! "
                  "Almost done..."),
    "blocked":   ("Hmm, I can't draw that. How about something "
                  "fun like an animal or a rainbow?"),
    "reboot":    "Rebooting now! See you in a moment.",
}

class VoiceFeedback:
    """Pre-generates TTS lines and caches them as .mp3 files."""

    def __init__(self):
        CACHE_DIR.mkdir(parents=True, exist_ok=True)
        self._cache = {}  # key → path (or list of paths)
        self._warm_up()

    def _tts_path(self, text):
        """Deterministic filename based on voice + text content."""
        h = hashlib.md5(f"{TTS_VOICE}:{text}".encode()).hexdigest()[:12]
        return CACHE_DIR / f"{h}.mp3"

    def _generate_one(self, text):
        """Generate a single TTS file if not already cached."""
        path = self._tts_path(text)
        if path.exists():
            return path
        print(f"   🔊 Caching: {text[:50]}...")
        try:
            resp = client.audio.speech.create(
                model="tts-1", voice=TTS_VOICE, input=text)
            resp.stream_to_file(str(path))
        except Exception as e:
            print(f"   ⚠️  TTS cache error: {e}")
            return None
        return path

    def _warm_up(self):
        """Pre-generate all static voice lines at startup."""
        print("🔊 Warming up voice cache...")
        for key, val in VOICE_LINES.items():
            if isinstance(val, list):
                paths = []
                for line in val:
                    p = self._generate_one(line)
                    if p: paths.append(p)
                self._cache[key] = paths
            else:
                p = self._generate_one(val)
                if p: self._cache[key] = p
        print("   ✅ Voice cache ready")

    def play(self, key, block=True):
        """Play a cached voice line by key.
        If block=False, plays in a background thread."""
        entry = self._cache.get(key)
        if entry is None:
            # Fallback: generate on the fly
            text = VOICE_LINES.get(key, key)
            if isinstance(text, list): text = random.choice(text)
            self._play_live(text)
            return
        if isinstance(entry, list):
            path = random.choice(entry) if entry else None
        else:
            path = entry
        if not path: return
        if block:
            self._play_file(path)
        else:
            threading.Thread(target=self._play_file,
                             args=(path,), daemon=True).start()

    def play_dynamic(self, text, block=True):
        """Speak arbitrary text (not cached). Used for
        transcription read-back or dynamic messages."""
        if block:
            self._play_live(text)
        else:
            threading.Thread(target=self._play_live,
                             args=(text,), daemon=True).start()

    def _play_file(self, path):
        try:
            time.sleep(0.5)  # let USB speaker wake up
            subprocess.run(["mpg123", "-q", str(path)], check=True)
        except Exception:
            # Fallback to aplay if mpg123 fails
            try:
                subprocess.run(["aplay", "-q", str(path)], check=False)
            except Exception:
                pass

    def _play_live(self, text):
        """Generate and play TTS on the fly (uncached)."""
        print(f"🔊 Speaking: {text}")
        try:
            resp = client.audio.speech.create(
                model="tts-1", voice=TTS_VOICE, input=text)
            tmp = tempfile.NamedTemporaryFile(suffix=".mp3", delete=False)
            resp.stream_to_file(tmp.name)
            self._play_file(tmp.name)
            os.unlink(tmp.name)
        except Exception as e:
            print(f"   TTS error: {e}")
            subprocess.run(["espeak", text], check=False)

# ── BEEP FALLBACK ──────────────────────────────
def beep(freq=440, dur=0.2):
    t = np.linspace(0, dur, int(SAMPLE_RATE * dur), False)
    sd.play((np.sin(freq * t * 2 * np.pi) * 0.3).astype(np.float32),
            SAMPLE_RATE)
    sd.wait()

def beep_ready():
    beep(523, 0.1); time.sleep(0.05)
    beep(659, 0.1); time.sleep(0.05)
    beep(784, 0.2)

# ── RECORD ──────────────────────────────────────
def record_audio():
    print(f"🎙️  Recording for {RECORD_SECONDS}s...")
    frames = []
    def cb(indata, fc, ti, st): frames.append(indata.copy())
    with sd.InputStream(samplerate=SAMPLE_RATE, channels=1, callback=cb):
        time.sleep(RECORD_SECONDS)
    if not frames: return None
    audio = np.concatenate(frames)
    if len(audio) / SAMPLE_RATE < 0.5: return None
    tmp = tempfile.NamedTemporaryFile(suffix=".wav", delete=False)
    sf.write(tmp.name, audio, SAMPLE_RATE)
    print(f"   Recorded {len(audio)/SAMPLE_RATE:.1f}s")
    return tmp.name

# ── TRANSCRIBE ──────────────────────────────────
def transcribe(path):
    print("📝 Transcribing...")
    with open(path, "rb") as f:
        r = client.audio.transcriptions.create(model="whisper-1", file=f)
    os.unlink(path)
    print(f'   Heard: "{r.text}"')
    return r.text

# ── GENERATE ────────────────────────────────────
def generate_image(desc):
    print(f"🎨 Generating: {desc}")
    r = client.images.generate(
        model="gpt-image-1",
        prompt=f"{COLORING_PROMPT}\n\nChild requested: {desc}",
        size="1024x1024", quality="medium")
    img_bytes = base64.b64decode(r.data[0].b64_json)
    img = Image.open(BytesIO(img_bytes)).convert("L")
    img = img.point(lambda x: 0 if x < 180 else 255, "1").convert("L")
    img = img.resize((1125, 1125), Image.LANCZOS)
    canvas = Image.new("L", (1275, 1650), 255)
    canvas.paste(img, (75, 262))
    tmp = tempfile.NamedTemporaryFile(suffix=".png", delete=False)
    canvas.save(tmp.name); tmp.close()
    return tmp.name

# ── PRINT ───────────────────────────────────────
def print_image(path):
    print("🖨️  Printing...")
    subprocess.run(["lp", "-d", PRINTER_NAME,
        "-o", "media=Letter", "-o", "fit-to-page", path], check=True)
    os.unlink(path)
    print("   ✅ Sent to printer!")

# ── MAIN ────────────────────────────────────────
is_busy = False

def main():
    global is_busy
    btn = GpioButton(BUTTON_PIN, pull_up=True, bounce_time=0.1)

    voice = VoiceFeedback()

    print("=" * 48)
    print("  🎨 DrawBox Ready!")
    print("  Press the red button to start!")
    print("=" * 48)
    voice.play("ready")

    try:
        while True:
            btn.wait_for_press()

            # ── LONG-PRESS REBOOT ──
            held = 0.0
            while btn.is_pressed:
                time.sleep(0.1)
                held += 0.1
                if held >= REBOOT_HOLD_SEC:
                    print("🔄 Reboot requested (5s hold)")
                    voice.play("reboot")
                    subprocess.run(["sudo", "reboot"])
                    return  # script exits; systemd won't restart (clean exit)
            # Button released before 5s — normal press

            # ── BUSY GUARD ──
            if is_busy:
                voice.play("busy", block=False)
                continue

            is_busy = True
            try:
                # LISTENING
                voice.play("listening")
                path = record_audio()

                if not path:
                    voice.play("too_short")
                elif not (text := transcribe(path)) or len(text.strip()) < 2:
                    voice.play("too_short")
                elif not is_safe(text):
                    print(f"🚫 Blocked: {text}")
                    voice.play("blocked")
                else:
                    # THINKING (random variation)
                    voice.play("thinking")
                    img = generate_image(text)

                    # PRINTING
                    voice.play("printing")
                    print_image(img)

                    # DONE
                    voice.play("done")

            except Exception as e:
                print(f"❌ Error: {e}")
                voice.play("error")
            finally:
                is_busy = False
            time.sleep(0.5)
    except KeyboardInterrupt:
        print("\n👋 Shutting down")

if __name__ == "__main__":
    main()

✓

Manual test (no button yet)

5 min▼

Test the image pipeline before wiring hardware:

bashpython3 -c " from openai import OpenAI import base64, subprocess, os, tempfile from PIL import Image from io import BytesIO client = OpenAI(api_key=os.environ['OPENAI_API_KEY']) print('Generating test image...') r = client.images.generate(model='gpt-image-1', prompt='Simple coloring page for kids: a happy dinosaur. Black and white line drawing, thick outlines, no shading.', size='1024x1024', quality='medium') print('Processing...') img = Image.open(BytesIO(base64.b64decode(r.data[0].b64_json))).convert('L') img = img.point(lambda x: 0 if x < 180 else 255, '1').convert('L') img = img.resize((1125, 1125), Image.LANCZOS) c = Image.new('L', (1275, 1650), 255) c.paste(img, (75, 262)) t = tempfile.NamedTemporaryFile(suffix='.png', delete=False) c.save(t.name); t.close() print('Printing...') subprocess.run(['lp','-d','drawbox-printer','-o','media=Letter','-o','fit-to-page',t.name]) os.unlink(t.name) print('Done! Check printer.') "

A dinosaur coloring page should print. If it does — core pipeline works! 🦕

🔧

Troubleshoot: API error → check echo $OPENAI_API_KEY · Image too dark → lower 180 to 150 · Too light → raise to 200 · Printer error → lpstat -p

✓

Set up auto-start on boot

3 min▼

Makes DrawBox start when Pi powers on — no SSH needed.

bashsudo tee /etc/systemd/system/drawbox.service << 'EOF' [Unit] Description=DrawBox AI Coloring Page Printer After=network-online.target cups.service Wants=network-online.target [Service] Type=simple User=pi Environment=OPENAI_API_KEY=sk-your-actual-key-here WorkingDirectory=/home/pi ExecStart=/usr/bin/python3 /home/pi/drawbox.py Restart=on-failure RestartSec=10 StartLimitBurst=5 StartLimitIntervalSec=300 [Install] WantedBy=multi-user.target EOF

bashsudo systemctl daemon-reload sudo systemctl enable drawbox sudo systemctl start drawbox # Check status sudo systemctl status drawbox # Watch live logs journalctl -u drawbox -f

⚠️

Replace sk-your-actual-key-here with your real key from Step 7. Replace pi if you used a different username. Systemd doesn't read ~/.bashrc, so the key must be set here too.

▶️

Video guide: Search: Raspberry Pi systemd autostart Python (https://www.youtube.com/results?search_query=raspberry+pi+systemd+service+autostart+python)

🔌

## Phase 4 — Hardware Wiring

Button, mic, speaker → Pi

✓

Wire the 100mm arcade button

10 min▼

The EG STARTS 100mm button has a microswitch underneath with 3 terminals: COM, NO, NC.

ℹ️

LED note: The built-in LED is 12V — Pi GPIO is 3.3V so the LED won't light. That's fine, the button works perfectly as a switch without it.

Wiring Diagram

EG STARTS 100mm Button              Raspberry Pi 5

  ┌─────────────┐
  │ Microswitch  │
  │              │
  │  COM ●───────────────────► Pin 11 (GPIO 17)
  │              │
  │  NO  ●───────────────────► Pin 9  (GND)
  │              │
  │  NC  ●       │  ← ignore, don't connect
  └─────────────┘

Pi GPIO Header (USB ports facing right):
         3V3  [1]  [2]  5V
             [3]  [4]  5V
             [5]  [6]  GND
             [7]  [8]
  GND ►  [9]  [10]
  GPIO17 ► [11] [12]

Steps: Attach wires to COM and NO on microswitch → COM → Pin 11 (GPIO 17), NO → Pin 9 (GND)

💡

Test: python3 -c "from gpiozero import Button; b=Button(17); print('pressed' if b.is_pressed else 'open')" → prints "open" normally, "pressed" when held down.

▶️

Video guide: Search: Arcade button Raspberry Pi GPIO wiring (https://www.youtube.com/results?search_query=arcade+button+raspberry+pi+GPIO+wiring)

✓

Plug in mic & speaker

5 min▼

⚠️

Pi 5 has no headphone jack! Audio output must go through USB or Bluetooth. We use a USB speaker plugged into a Pi USB port.

CHANGEEK mic: USB-A into any free Pi port. Gooseneck bends through enclosure slot.

bash# Verify mic is detected arecord -l # Should show "USB PnP Sound Device" # Test record (5 sec) arecord -d 5 -f S16_LE -r 44100 test.wav

USB speaker: Plug into another USB-A port on the Pi.

bash# Verify speaker is detected aplay -l # Should show a "USB Audio" or "USB Speaker" device # Play back your test recording through USB speaker aplay test.wav # Test with a tone speaker-test -t wav -c 1

Set default audio devices: The Pi sees multiple sound cards. Create ~/.asoundrc to route audio correctly:

bash# Check your card numbers (mic and speaker will differ per Pi) arecord -l # note the card number for "USB PnP Sound Device" aplay -l # note the card number for your USB speaker # Create ALSA config (adjust card numbers to match yours) cat > ~/.asoundrc << 'EOF' pcm.!default { type asym playback.pcm "plug:hw:3,0" capture.pcm "plug:hw:2,0" } ctl.!default { type hw card 3 } EOF

⚠️

Card numbers vary! Your mic might be card 2 and speaker card 3, or different. Use the numbers from arecord -l and aplay -l above. After creating .asoundrc, test with: arecord -d 3 test.wav && aplay test.wav

Temporary alternative: Bluetooth speaker

If you don't have a USB speaker yet, the Pi 5 has built-in Bluetooth. Pair any Bluetooth speaker:

bash# Start Bluetooth pairing bluetoothctl # Inside bluetoothctl: power on agent on scan on # Wait for your speaker to appear, note its MAC address (XX:XX:XX:XX:XX:XX) pair XX:XX:XX:XX:XX:XX trust XX:XX:XX:XX:XX:XX connect XX:XX:XX:XX:XX:XX exit # Verify audio routes to Bluetooth speaker-test -t wav -c 1

💡

Auto-reconnect: After trusting a Bluetooth speaker, PipeWire (Pi OS Bookworm) will auto-reconnect on boot — as long as the speaker is powered on and in range. If it drops, reconnect manually: bluetoothctl connect XX:XX:XX:XX:XX:XX

▶️

Video guide: Search: Raspberry Pi 5 USB audio & Bluetooth speaker setup (https://www.youtube.com/results?search_query=raspberry+pi+5+usb+audio+bluetooth+speaker+setup)

✓

Full integration test

5 min▼

bashsudo systemctl stop drawbox # stop service python3 ~/drawbox.py # run manually to see output

The moment of truth:

1. Watch console for "Warming up voice cache…" — first run caches all TTS lines ✓

2. Hear: "Ready! Press the button and tell me what to draw!" ✓

3. Press the big red button ✓

4. Hear: "I'm listening!" — speak: "a happy cat wearing a birthday hat" ✓

5. Hear a random thinking line like: "Ooh, great idea! Let me draw that for you!" ✓

6. Hear: "Here it comes!" — printer starts ✓

7. Hear: "All done! Press the button when you want another one!" ✓

8. Press button while busy — hear: "Hold on, I'm still working…" (ignored) ✓

9. Coloring page prints in ~20-30 seconds! 🎉🎉🎉

bash# Once verified, restart auto-start sudo systemctl start drawbox

📦

## Phase 5 — Cardboard Enclosure

Two-piece: Printer Shell + Control Deck

✓

Cut all panels

20 min▼

Using your Golden State Art sheets. White side faces OUT. Cut all holes before assembly.

⚠️

Updated for 100mm button: Button hole is 100mm. Control Deck height is 80mm for dome clearance. Mic gets a 30×15mm slot for the gooseneck.

Panel | Part | Size (mm) | Holes
A | Shell — Back | 400 × 220 | ⌀30mm + ⌀25mm (cables, near bottom)
B | Shell — Left | 395 × 220 | None
C | Shell — Right | 395 × 220 | None
D | Shell — Top | 400 × 395 | 280×150mm output window
E | Deck — Top | 400 × 170 | ⌀100mm button, 30×15mm mic slot
F | Deck — Bottom | 400 × 170 | None
G | Deck — Front | 400 × 80 | None
H | Deck — Back | 400 × 80 | 18×10mm USB-C + ⌀20mm USB
I | Deck — Left | 164 × 80 | None
J | Deck — Right | 164 × 80 | None
K | Lip Strips ×4 | 2× 400×15 + 2× 170×15 | None

Deck Top Panel (E) — Hole Positions

✓

Build the Printer Shell

15 min▼

White side OUT on all panels.

1. Stand Panel A (back) upright. Glue Panel B (left) at 90° to its left edge, flush bottom. Glue Panel C (right) to the other side. → U-shape.

U-Shape (top view)

2. Glue Panel D (top) onto all three walls. Output window faces the front, 70mm solid at back.

3. Slide Brother printer in from front. Thread cables through back holes.

✓

Build Control Deck & install components

20 min▼

1. Build the box: Panel F (bottom) flat → glue walls G, H, I, J around edges. Don't glue top yet.

2. Install inside:

Internal Layout (top view, lid off)

a. Pi → bottom with foam tape (left side, USB ports right)
b. Snap 100mm button into Panel E top hole
c. Feed CHANGEEK mic USB through slot, gooseneck pointing up
d. Button wires: COM→GPIO 17, NO→GND
e. USB mic → Pi USB port
f. USB speaker → Pi USB port (can sit outside or inside the enclosure)
g. USB-B cable out back → down to printer
h. USB-C power out back slot

3. Close top: Use velcro strips (not glue) so you can open for maintenance.

4. Add lip strips: Glue K strips around underside bottom edges — they nest inside the Shell walls.

✓

Finishing touches

10 min▼

White cardboard = clean look already. No wrapping needed!

Labels (print on the Brother and glue on):

"🎙️ PRESS TO START" — next to button
"🎨 DrawBox" — front of Control Deck

Stick 4 rubber bumper pads on bottom. Place Deck on Shell. Plug in power. Load paper. Wait for ready chime.

Final Assembly

🎉

DrawBox Complete!

Press the button, say something, watch the magic happen.

📶

## Phase 6 — Finishing Up

WiFi portability, cost protection, and reliability

✓

WiFi portability

3 min▼

DrawBox needs WiFi to reach the OpenAI API. Here's how to connect it to a new network (grandma's house, school, vacation rental…).

Option A — SSH in and switch:

bash# From your laptop (same WiFi first) ssh pi@drawbox.local # Scan available networks nmcli dev wifi list # Connect to new network sudo nmcli dev wifi connect "New-WiFi-Name" password "wifi-password" # Verify ping -c 3 google.com

Option B — Pre-save multiple networks (set-and-forget):

bash# Add grandma's WiFi now — Pi auto-connects when in range sudo nmcli con add type wifi ifname wlan0 con-name "Grandma" \ ssid "Grandma-WiFi" wifi-sec.key-mgmt wpa-psk \ wifi-sec.psk "grandma-password" # List all saved networks nmcli con show # Remove one you don't need anymore sudo nmcli con delete "Grandma"

💡

Pro tip: Name your phone hotspot the same SSID and password as your home WiFi. DrawBox will auto-connect to your phone's hotspot anywhere — instant portable WiFi, no config needed.

ℹ️

Pi OS Bookworm uses NetworkManager by default, so nmcli works out of the box. No extra packages needed.

✓

Cost cap & reliability

3 min▼

🚨

Set a spending limit — do this now!
Go to platform.openai.com → Settings → Billing → Usage Limits.
Set a monthly hard cap of $10–20. At ~$0.06/page, that's 150–300 coloring pages per month.
This prevents a stuck button or bug from racking up a surprise bill.

Crash protection: The service file (Step 10) is already configured to restart on failure, but stop after 5 crashes in 5 minutes. This prevents a broken API key or network outage from burning through retries.

bash# Check if service is running sudo systemctl status drawbox # View recent logs journalctl -u drawbox -e --no-pager -n 30 # Restart after fixing an issue sudo systemctl restart drawbox

Log rotation: Prevent the journal from filling your SD card over time:

bash# Trim logs to 50 MB max sudo journalctl --vacuum-size=50M

ℹ️

Voice cache: The TTS cache at ~/.drawbox/voice_cache/ is tiny (~2 MB). It regenerates automatically if you delete it. No maintenance needed.

ℹ️

What happens if WiFi drops? The script catches the error, says "Oops, something went wrong. Try again!", and waits for the next button press. No data is lost. Once WiFi is back, it works again.

💡

Safe reboot: Hold the button for 5 seconds to safely reboot the Pi. DrawBox says "Rebooting now!" and restarts cleanly. Never yank the power cable — that can corrupt the SD card over time.

✓

Web dashboard

2 min▼

A lightweight web dashboard running on the Pi that you can access from any browser on your local network — your Mac, phone, tablet, whatever. Trigger prints, see logs, change settings, run diagnostics, and access Raspberry Pi Connect — all from http://drawbox.local:5000.

One-command deploy from your Mac:

terminal (on your Mac)# From the drawbox project folder on your Mac: ./deploy-web.sh

That's it! The script automatically:

1. Copies drawbox_web.py, drawbox-guide.html, and drawbox-simulator.html to the Pi

2. Installs Flask if missing

3. Configures sudoers for service control

4. Reads your OpenAI API key from the existing drawbox.service

5. Creates and starts the drawbox-web systemd service

6. Verifies the dashboard is responding

ℹ️

Re-deploy anytime: Made changes? Just run ./deploy-web.sh again — it's idempotent. Files get overwritten and the service restarts.

Open it! Go to http://drawbox.local:5000 from any browser on your network.

Manual setup (if you prefer):

Click to expand manual steps

drawbox_web.py

#!/usr/bin/env python3
"""DrawBox Web Dashboard — Control panel accessible from any browser on your network."""

import os, json, tempfile, subprocess, base64
from pathlib import Path
from io import BytesIO
from flask import Flask, request, jsonify, Response, render_template_string, send_file
from openai import OpenAI
from PIL import Image

# ── CONFIG ───────────────────────────────────────
OPENAI_API_KEY = os.environ.get("OPENAI_API_KEY")
PRINTER_NAME = "drawbox-printer"
SETTINGS_FILE = Path.home() / ".drawbox" / "web_settings.json"
GUIDE_PATH = Path.home() / "drawbox-guide.html"
SIMULATOR_PATH = Path.home() / "drawbox-simulator.html"

DEFAULT_COLORING_PROMPT = """Create a simple coloring page for children ages 3-8.
This is used by YOUNG CHILDREN — output MUST be 100% child-safe.
- Black and white LINE DRAWING only
- Thick, clean outlines (3-4px stroke)
- NO shading, NO gradients, NO filled/solid areas
- NO gray — pure black lines on white
- Simple shapes, minimal fine detail
- Large open areas for coloring with crayons
- Friendly, fun, cute, non-scary style
- Centered, filling most of the space
- Style: children's coloring book page
- ONLY draw safe, wholesome subjects (animals, nature, vehicles, food, toys)
- NEVER draw anything violent, scary, sexual, or inappropriate for a 5-year-old
- If the request is ambiguous, default to the most innocent interpretation"""

# ── SAFETY BLOCKLIST ─────────────────────────────
BLOCKED_WORDS = {
    "kill", "murder", "dead", "death", "die", "dying", "corpse",
    "blood", "bloody", "gore", "gory", "wound", "stab", "shoot",
    "gun", "guns", "rifle", "pistol", "shotgun", "weapon", "knife",
    "bomb", "explode", "explosion", "grenade", "missile", "nuke",
    "sex", "sexy", "sexual", "nude", "naked", "porn", "hentai",
    "penis", "dick", "cock", "vagina", "pussy", "boob", "breast",
    "nipple", "butt", "ass", "anus", "genital", "erotic", "orgasm",
    "fuck", "shit", "damn", "bitch", "bastard", "crap", "piss",
    "whore", "slut", "hooker", "prostitute", "stripper",
    "drug", "drugs", "cocaine", "heroin", "meth", "weed", "marijuana",
    "alcohol", "beer", "wine", "vodka", "drunk", "cigarette", "smoke",
    "devil", "satan", "demon", "hell", "torture", "horror", "zombie",
    "vampire", "skeleton", "skull", "coffin", "grave", "creepy",
    "scary", "nightmare", "terror", "evil", "wicked", "curse",
    "hate", "racist", "racism", "nazi", "hitler", "slavery", "slave",
    "suicide", "hanging", "noose", "drown", "poison", "overdose",
    "rape", "molest", "abuse", "kidnap", "assault", "victim",
    "war", "soldier", "army", "military", "combat", "battle",
    "thong", "lingerie", "bikini", "underwear",
    "pee", "fart", "vomit", "snot",
}

def is_safe(text):
    words = text.lower()
    return not any(w in words for w in BLOCKED_WORDS)

# ── SETTINGS ─────────────────────────────────────
def load_settings():
    if SETTINGS_FILE.exists():
        try:
            return json.loads(SETTINGS_FILE.read_text())
        except Exception:
            pass
    return {"coloring_prompt": DEFAULT_COLORING_PROMPT,
            "tts_voice": "nova", "record_seconds": 10}

def save_settings(data):
    SETTINGS_FILE.parent.mkdir(parents=True, exist_ok=True)
    SETTINGS_FILE.write_text(json.dumps(data, indent=2))

# ── IMAGE GENERATION & PRINTING ──────────────────
client = OpenAI(api_key=OPENAI_API_KEY)
is_generating = False
last_image_b64 = None

def generate_image(desc):
    settings = load_settings()
    prompt = settings.get("coloring_prompt", DEFAULT_COLORING_PROMPT)
    r = client.images.generate(
        model="gpt-image-1",
        prompt=f"{prompt}\n\nChild requested: {desc}",
        size="1024x1024", quality="medium")
    img_bytes = base64.b64decode(r.data[0].b64_json)
    img = Image.open(BytesIO(img_bytes)).convert("L")
    img = img.point(lambda x: 0 if x < 180 else 255, "1").convert("L")
    img = img.resize((1125, 1125), Image.LANCZOS)
    canvas = Image.new("L", (1275, 1650), 255)
    canvas.paste(img, (75, 262))
    tmp = tempfile.NamedTemporaryFile(suffix=".png", delete=False)
    canvas.save(tmp.name); tmp.close()
    return tmp.name

def print_image(path):
    subprocess.run(["lp", "-d", PRINTER_NAME,
        "-o", "media=Letter", "-o", "fit-to-page", path], check=True)
    os.unlink(path)

# ── DIAGNOSTICS ALLOWLIST ────────────────────────
DIAGNOSTIC_COMMANDS = {
    "printer_status": ["lpstat", "-p", "-d"],
    "printer_queue":  ["lpstat", "-o"],
    "audio_inputs":   ["arecord", "-l"],
    "audio_outputs":  ["aplay", "-l"],
    "service_status": ["systemctl", "status", "drawbox"],
    "web_service":    ["systemctl", "status", "drawbox-web"],
    "disk_usage":     ["df", "-h", "/"],
    "uptime":         ["uptime"],
    "temperature":    ["vcgencmd", "measure_temp"],
    "wifi_status":    ["nmcli", "-t", "-f", "ACTIVE,SSID,SIGNAL", "dev", "wifi"],
    "wifi_list":      ["nmcli", "dev", "wifi", "list"],
    "rpi_connect":    ["rpi-connect", "status"],
    "journal_errors": ["journalctl", "-u", "drawbox", "-p", "err", "-n", "20", "--no-pager"],
    "cups_log":       ["tail", "-n", "30", "/var/log/cups/error_log"],
}

# ── FLASK APP ────────────────────────────────────
app = Flask(__name__)

HTML = """

DrawBox Dashboard

Control panel for your AI coloring page printer

      📖 Build Guide
      🎮 Simulator
      🔌 RPi Connect (https://connect.raspberrypi.com)

⚡ Status

DrawBox Service

Pi Temperature

Uptime

RPi Connect

🎨 Generate & Print

        Generate & Print

📜 Live Logs Clear

Connecting to log stream...\n

⚙ Settings

        Coloring Prompt

        TTS Voice

        Record Seconds

        Save Settings
        Reset

🔧 Diagnostics

        Printer Status
        Print Queue
        Audio Inputs
        Audio Outputs
        Service Status
        Web Service
        Disk Usage
        Temperature
        WiFi Status
        WiFi Networks
        RPi Connect
        Error Logs
        CUPS Log

Click a button above to run a diagnostic command.

⚙ Service Control

        Restart DrawBox
        Stop DrawBox
        Start DrawBox
        Reboot Pi

"""

# ── ROUTES ───────────────────────────────────────

@app.route("/")
def index():
    return render_template_string(HTML)

@app.route("/guide")
def guide():
    if GUIDE_PATH.exists():
        return send_file(GUIDE_PATH)
    return "Guide not found. Copy drawbox-guide.html to ~/", 404

@app.route("/simulator")
def simulator():
    if SIMULATOR_PATH.exists():
        return send_file(SIMULATOR_PATH)
    return "Simulator not found. Copy drawbox-simulator.html to ~/", 404

@app.route("/api/status")
def api_status():
    # Service status
    svc = subprocess.run(["systemctl", "is-active", "drawbox"],
                         capture_output=True, text=True)
    running = svc.stdout.strip() == "active"

    # Temperature
    temp = "--"
    try:
        t = subprocess.run(["vcgencmd", "measure_temp"],
                           capture_output=True, text=True, timeout=5)
        temp = t.stdout.strip().replace("temp=", "")
    except Exception:
        pass

    # Uptime
    up = "--"
    try:
        u = subprocess.run(["uptime", "-p"],
                           capture_output=True, text=True, timeout=5)
        up = u.stdout.strip().replace("up ", "")
    except Exception:
        pass

    # RPi Connect
    rpi = "unknown"
    try:
        rc = subprocess.run(["rpi-connect", "status"],
                            capture_output=True, text=True, timeout=5)
        out = rc.stdout.strip().lower()
        if "connected" in out:
            rpi = "connected"
        elif "not" in out or rc.returncode != 0:
            rpi = "off"
        else:
            rpi = out[:20]
    except FileNotFoundError:
        rpi = "not installed"
    except Exception:
        pass

    return jsonify(service_running=running, temperature=temp,
                   uptime=up, rpi_connect=rpi)

@app.route("/api/generate", methods=["POST"])
def api_generate():
    global is_generating, last_image_b64
    if is_generating:
        return jsonify(ok=False, error="Already generating — please wait.")

    data = request.get_json() or {}
    desc = (data.get("description") or "").strip()
    if not desc:
        return jsonify(ok=False, error="Please describe what to draw.")
    if len(desc) > 500:
        return jsonify(ok=False, error="Description too long (max 500 chars).")
    if not is_safe(desc):
        return jsonify(ok=False,
            error="That description contains blocked words. "
                  "Try something fun like an animal or a rainbow!")

    is_generating = True
    try:
        path = generate_image(desc)
        # Read image for preview before printing
        with open(path, "rb") as f:
            last_image_b64 = base64.b64encode(f.read()).decode()
        print_image(path)
        return jsonify(ok=True, image=last_image_b64)
    except Exception as e:
        return jsonify(ok=False, error=str(e))
    finally:
        is_generating = False

@app.route("/api/logs")
def api_logs():
    def generate():
        proc = subprocess.Popen(
            ["journalctl", "-u", "drawbox", "-f", "-n", "50", "--no-pager"],
            stdout=subprocess.PIPE, stderr=subprocess.STDOUT, text=True)
        try:
            for line in proc.stdout:
                yield f"data: {line.rstrip()}\n\n"
        except GeneratorExit:
            proc.kill()
    return Response(generate(), mimetype="text/event-stream",
                    headers={"Cache-Control": "no-cache",
                             "X-Accel-Buffering": "no"})

@app.route("/api/settings", methods=["GET", "POST"])
def api_settings():
    if request.method == "GET":
        return jsonify(load_settings())
    data = request.get_json() or {}
    settings = load_settings()
    if "coloring_prompt" in data:
        settings["coloring_prompt"] = data["coloring_prompt"][:5000]
    if "tts_voice" in data:
        settings["tts_voice"] = data["tts_voice"]
    if "record_seconds" in data:
        settings["record_seconds"] = max(3, min(30, int(data["record_seconds"])))
    save_settings(settings)
    return jsonify(ok=True)

@app.route("/api/diagnostics", methods=["POST"])
def api_diagnostics():
    data = request.get_json() or {}
    cmd_key = data.get("command", "")
    if cmd_key not in DIAGNOSTIC_COMMANDS:
        return jsonify(error="Unknown command: " + cmd_key)
    cmd = DIAGNOSTIC_COMMANDS[cmd_key]
    try:
        r = subprocess.run(cmd, capture_output=True, text=True, timeout=15)
        output = r.stdout
        if r.stderr:
            output += "\n" + r.stderr
        return jsonify(output=output.strip() or "(no output)")
    except FileNotFoundError:
        return jsonify(output=f"Command not found: {cmd[0]}")
    except subprocess.TimeoutExpired:
        return jsonify(output="Command timed out after 15 seconds.")
    except Exception as e:
        return jsonify(error=str(e))

@app.route("/api/service/", methods=["POST"])
def api_service(action):
    if action not in ("restart", "stop", "start"):
        return jsonify(ok=False, message="Invalid action"), 400
    try:
        subprocess.run(["sudo", "systemctl", action, "drawbox"],
                       check=True, timeout=30)
        return jsonify(ok=True,
                       message=f"DrawBox service {action}ed successfully.")
    except Exception as e:
        return jsonify(ok=False, message=str(e))

@app.route("/api/reboot", methods=["POST"])
def api_reboot():
    try:
        subprocess.Popen(["sudo", "reboot"])
        return jsonify(ok=True, message="Rebooting...")
    except Exception as e:
        return jsonify(ok=False, message=str(e))

# ── MAIN ─────────────────────────────────────────
if __name__ == "__main__":
    SETTINGS_FILE.parent.mkdir(parents=True, exist_ok=True)
    print("DrawBox Web Dashboard starting on http://0.0.0.0:5000")
    app.run(host="0.0.0.0", port=5000, debug=False, threaded=True)

5. Create the systemd service:

bashsudo tee /etc/systemd/system/drawbox-web.service << 'EOF' [Unit] Description=DrawBox Web Dashboard After=network-online.target Wants=network-online.target [Service] Type=simple User=pi Environment=OPENAI_API_KEY=sk-your-actual-key-here WorkingDirectory=/home/pi ExecStart=/usr/bin/python3 /home/pi/drawbox_web.py Restart=on-failure RestartSec=10 [Install] WantedBy=multi-user.target EOF

6. Enable and start:

bashsudo systemctl daemon-reload sudo systemctl enable drawbox-web sudo systemctl start drawbox-web # Check it's running sudo systemctl status drawbox-web

💡

Phone access: Open http://drawbox.local:5000 on your phone (same WiFi). You can generate coloring pages, check logs, and restart the service — all from the couch. Add it to your home screen for quick access.

ℹ️

RPi Connect: If you have Raspberry Pi Connect (https://connect.raspberrypi.com) configured, the dashboard shows its status and links directly to the remote access portal. You can also check its status from the Diagnostics panel.

ℹ️

API key: The deploy script automatically reads your key from drawbox.service or ~/.bashrc. If neither exists, pass it manually: ./deploy-web.sh pi@drawbox.local sk-your-key

💡

Health check: Run ./check.sh from your Mac to verify the entire Pi setup — internet, API key, mic, speaker, printer, GPIO, dependencies, script correctness, and services. It SSHes into the Pi and checks everything automatically.

🔧

## Troubleshooting

Quick fixes for common issues

Problem | Fix
Printer not detected | lsusb — Brother showing? Try different USB port. Replug. sudo tail /var/log/cups/error_log
Mic not recording | arecord -l to list. Set device explicitly in script if multiple found.
No speaker sound | aplay -l to verify USB speaker is detected. speaker-test -t wav. If using Bluetooth: bluetoothctl connect XX:XX:XX:XX:XX:XX
Button no response | Test: python3 -c "from gpiozero import Button; b=Button(17); print('pressed' if b.is_pressed else 'open')"
Images too dark | Lower threshold: change 180 to 150 in script
Image generation errors | echo $OPENAI_API_KEY, check billing at platform.openai.com, ping google.com
Service won't start | journalctl -u drawbox -e — usually wrong API key or username in service file
WiFi won't connect | nmcli dev wifi list to scan. sudo nmcli dev wifi connect "SSID" password "pass". Or use phone hotspot with same SSID as home WiFi.
Service keeps crashing | journalctl -u drawbox -e to see errors. After 5 crashes in 5 min the service stops — fix the issue, then sudo systemctl start drawbox
Need to reboot | Hold the big red button for 5 seconds. DrawBox says "Rebooting now!" and restarts safely. Don't unplug — that risks SD card corruption.
Dashboard not loading | sudo systemctl status drawbox-web — is it running? curl http://localhost:5000 from the Pi. Check Flask is installed: python3 -c "import flask". Make sure you're on the same WiFi network.
SSH dies after reboot | Enable both units: sudo systemctl enable ssh.socket && sudo systemctl enable ssh.service. Then reboot and test.
Not sure what's wrong | Run ./check.sh from your Mac — it checks everything (internet, API key, mic, speaker, printer, GPIO, dependencies, script, services) and shows ✅/❌/⚠️ for each.
