maximeprades/drawbox/PI-SETUP.md

# DrawBox Pi Setup Guide

How to SSH into your Raspberry Pi and update DrawBox with the new FLUX Schnell image generation.

---

## 1. Find Your Pi on the Network

Your Pi should be reachable at `drawbox.local` if mDNS is working. Test it:

```bash
ping drawbox.local
```

If that doesn't work, find the Pi's IP address from your router's admin page (usually `192.168.1.1`), or connect a monitor to the Pi and run `hostname -I`.

## 2. SSH Into the Pi

From your Mac's Terminal:

```bash
ssh pi@drawbox.local
```

- Default username: `pi`
- Enter your password when prompted (the default Raspberry Pi OS password is `raspberry` if you haven't changed it)
- If you've never SSH'd before, type `yes` when it asks about the host fingerprint

If `drawbox.local` doesn't resolve, use the IP directly:

```bash
ssh pi@192.168.1.XXX
```

## 3. Get a Replicate API Token

1. Go to [replicate.com](https://replicate.com) in your browser
2. Sign up (you can use GitHub login)
3. Go to **Account Settings** (click your avatar top-right) > **API tokens**
4. Click **Create token**
5. Copy the token — it looks like `r8_xxxxxxxxxxxxxxxxxxxxxxxxxxxxxxxxxxxxxxxx`

Replicate gives free credits to start. FLUX Schnell costs ~$0.003 per image (~330 images per dollar).

## 4. Install the Replicate Python Package

On the Pi (via SSH):

```bash
sudo pip3 install --break-system-packages replicate
```

Verify it installed:

```bash
python3 -c "import replicate; print('OK')"
```

## 5. Pull the Latest Code

On the Pi:

```bash
cd ~/
```

If you have the repo cloned:

```bash
cd drawbox && git pull && cp drawbox_core.py drawbox.py drawbox_web.py drawbox-simulator.html ~/ && mkdir -p ~/templates && cp templates/index.html ~/templates/
```

Or copy files from your Mac (run this **from your Mac**, not the Pi):

```bash
cd /Users/maximep/Documents/Code/drawbox
scp drawbox_core.py drawbox.py drawbox_web.py drawbox-simulator.html check.sh deploy-web.sh pi@drawbox.local:~/
ssh pi@drawbox.local "mkdir -p ~/templates"
scp templates/index.html pi@drawbox.local:~/templates/
```

## 6. Add Your API Key

Do NOT put API keys in the systemd service files: those are world-readable
(mode 644), and DrawBox no longer reads keys from them. Keys live in
`~/.drawbox/api_keys.json` (mode 600), managed from the dashboard.

Once the dashboard is running (next step), open
`http://drawbox.local:5000`, go to **Settings → API Keys**, and paste your
`AI_GATEWAY_API_KEY` (plus ElevenLabs or xAI keys only if you switch the
voice provider). The image model is picked in Settings too — no
environment variables needed.

The main service file stays key-free:

```ini
[Service]
Type=simple
User=pi
WorkingDirectory=/home/pi
ExecStart=/usr/bin/python3 /home/pi/drawbox.py
Restart=on-failure
RestartSec=10
```

## 7. Reload and Restart Services

```bash
sudo systemctl daemon-reload
sudo systemctl restart drawbox
sudo systemctl restart drawbox-web
```

Verify they're running:

```bash
sudo systemctl status drawbox
sudo systemctl status drawbox-web
```

Both should say **active (running)**.

## 8. Run the Health Check

```bash
bash ~/check.sh
```

This verifies: internet, API keys (OpenAI + Replicate), mic, speaker, printer, GPIO, Python deps, services, and voice cache.

## 9. Clear the Old Voice Cache (One-Time)

The voice lines changed, so the old cached audio files are stale. Clear them to force re-generation:

```bash
rm -rf ~/.drawbox/voice_cache
```

The cache will rebuild automatically on next startup (~2 minutes for 50 jokes + 15 voice lines).

## 10. Set the Mic Gain (One-Time)

The speech detection uses the same thresholds as the ESP32 box (room tone
below 0.017, speech above 0.034). They need the USB mic at capture volume
8 of 16. At 0, speech reads as silence and every press ends with
"I didn't catch that". On the Pi:

```bash
amixer -c Device cset name='Mic Capture Volume' 8
sudo alsactl store
```

`Device` is the mic's card name from `arecord -l`. `alsactl store` saves
the level, and ALSA restores it at boot and when the mic is replugged.
Every take logs its peak in `journalctl -u drawbox`, for example
`recorded 4.6s (peak 0.152)`. At gain 8, speech peaks near 0.15 and the
quiet room stays under 0.015.

## 11. Test It

Press the red button and say something! Image generation should now take ~2-5 seconds instead of 30-60 seconds.

Check the logs if anything goes wrong:

```bash
journalctl -u drawbox -f
```

(Press `Ctrl+C` to stop following the log.)

---

## Quick Reference

| Task | Command |
|---|---|
| SSH into Pi | `ssh pi@drawbox.local` |
| Check service status | `sudo systemctl status drawbox` |
| Restart DrawBox | `sudo systemctl restart drawbox` |
| Restart web dashboard | `sudo systemctl restart drawbox-web` |
| View live logs | `journalctl -u drawbox -f` |
| View web dashboard logs | `journalctl -u drawbox-web -f` |
| Run health check | `bash ~/check.sh` |
| Edit main service file | `sudo nano /etc/systemd/system/drawbox.service` |
| Edit web service file | `sudo nano /etc/systemd/system/drawbox-web.service` |
| Reload after editing services | `sudo systemctl daemon-reload` |
| Reboot Pi | `sudo reboot` |

## One-Command Deploy (Alternative)

If you prefer, the deploy script handles everything automatically from your Mac:

```bash
./deploy-web.sh
```

This copies files to the Pi, installs dependencies (Flask, gunicorn, replicate), and restarts the web dashboard service. You'll still need to manually add `REPLICATE_API_TOKEN` to the main `drawbox.service` file (Step 6).

## Remote Access with Cloudflare Tunnel (Optional)

To access your DrawBox dashboard and SSH from anywhere:

```bash
./deploy-tunnel.sh pi@drawbox.local mybox yourdomain.com
```

This creates a Cloudflare Tunnel exposing the dashboard and SSH. See the [README](README.md#remote-access-optional) for details and prerequisites.
