maximeprades/drawbox/firmware/esp32_amoled_button/pin_config.h

// Waveshare ESP32-S3-Touch-AMOLED-2.16 pin map, from the vendor's
// board examples (waveshareteam/ESP32-S3-Touch-AMOLED-2.16).
#pragma once

#define LCD_SDIO0 4
#define LCD_SDIO1 5
#define LCD_SDIO2 6
#define LCD_SDIO3 7
#define LCD_SCLK 38
#define LCD_RESET 39
#define LCD_CS 12
#define LCD_WIDTH 480
#define LCD_HEIGHT 480

#define IIC_SDA 15
#define IIC_SCL 14
#define TP_INT 11
#define TP_RST 40

#define PIN_ES7210_BCLK 9
#define PIN_ES7210_LRCK 45
#define PIN_ES7210_DIN 10
#define PIN_ES7210_MCLK 42

// ES8311 codec shares the same I2S clocks; speaker data out + amp enable.
#define PIN_ES8311_DOUT 8
#define PIN_PA 46
