maximeprades/drawbox/drawbox_escpos.py

#!/usr/bin/env python3
"""ESC/POS raster rendering + serial/TCP output for thermal receipt printers.

Drives the M5Stack ATOM Printer (SKU K118) — an ESP32-driven 58mm ESC/POS
serial thermal printer — and any compatible ESC/POS serial printer. The ATOM
ships with an AP/MQTT firmware that never exposes the print head over USB, so
it must be flashed once with the bridge sketch in
``firmware/atom_printer_bridge_wifi/`` (one command, see its README). After
that it is a dumb printer on WiFi (raw TCP, port 9100) and USB serial.

Only the Python stdlib and Pillow are needed — no pyserial, no python-escpos.

Hardware smoke test (prints a built-in test pattern):

    python3 drawbox_escpos.py --port /dev/ttyUSB0
"""

import argparse
import fcntl
import logging
import os
import socket
import termios
import threading

from PIL import Image, ImageOps

log = logging.getLogger("drawbox.escpos")

PRINTER_WIDTH_DOTS = 384
BAND_ROWS = 255  # max rows per GS v 0 block
FEED_LINES = 4
# ~2 cm of blank paper after each page (160 dots at 203 dpi): enough for
# the last printed line to clear the head-to-tear-bar distance, so
# tearing can't cut the drawing and pages don't smudge together.
TRAILING_GAP_DOTS = 160

INIT = b"\x1b\x40"
FEED_BYTES = b"\x0a" * FEED_LINES


def render_raster(img):
    """Render a PIL image into a complete ESC/POS print job (bytes)."""
    gray = img.convert("L")
    bbox = ImageOps.invert(gray).getbbox()
    if bbox is None:
        log.warning("image is entirely white — printing paper feed only")
        return INIT + FEED_BYTES
    gray = gray.crop(bbox)
    w, h = gray.size
    gray = gray.resize(
        (PRINTER_WIDTH_DOTS, max(1, round(h * PRINTER_WIDTH_DOTS / w))),
        Image.LANCZOS,
    )
    # PIL packs mode "1" with white=1; ESC/POS raster wants black=1.
    data = bytes(b ^ 0xFF for b in gray.convert("1").tobytes())
    row_bytes = PRINTER_WIDTH_DOTS // 8
    # The tear-off gap rides in blank raster rows because the ATOM's
    # clone head silently ignores ESC J: prints made with an ESC J gap
    # kept their bottoms inside the printer, and tearing cut them off.
    # Raster rows it must execute, or images wouldn't print at all.
    data += b"\x00" * (row_bytes * TRAILING_GAP_DOTS)
    job = [INIT]
    for start in range(0, len(data), row_bytes * BAND_ROWS):
        band = data[start:start + row_bytes * BAND_ROWS]
        rows = len(band) // row_bytes
        # GS v 0: mode, then width in bytes and height in dots, little-endian.
        job.append(b"\x1d\x76\x30\x00" + bytes([
            row_bytes & 0xFF, row_bytes >> 8, rows & 0xFF, rows >> 8,
        ]))
        job.append(band)
    job.append(FEED_BYTES)
    return b"".join(job)


def _open_serial(port, baud):
    """Open ``port`` as a raw 8N1 serial fd at ``baud``, no flow control."""
    speed = getattr(termios, "B%d" % baud, None)
    if speed is None:
        raise ValueError("unsupported baud rate: %s" % baud)
    fd = os.open(port, os.O_RDWR | os.O_NOCTTY)
    try:
        cc = termios.tcgetattr(fd)[6]
        iflag = oflag = lflag = 0
        cflag = termios.CS8 | termios.CLOCAL | termios.CREAD
        termios.tcsetattr(fd, termios.TCSANOW,
                          [iflag, oflag, cflag, lflag, speed, speed, cc])
    except Exception:
        os.close(fd)
        raise
    return fd


def _pump(fd, job):
    """Write ``job`` to ``fd`` and drain it. Always closes ``fd``."""
    try:
        # flock, not a threading lock: the button daemon and the web
        # dashboard print from separate processes, and interleaved writes
        # would corrupt the raster mid-job.
        fcntl.flock(fd, fcntl.LOCK_EX)
        view = memoryview(job)
        while view:
            view = view[os.write(fd, view):]
        termios.tcdrain(fd)
    finally:
        os.close(fd)  # also releases the flock


def _open_tcp(host, port):
    """Connect to a raw ESC/POS TCP bridge (the WiFi ATOM sketch)."""
    return socket.create_connection((host, int(port)), timeout=10)


def _write_timeout(job_len):
    """Deadline for writing a whole job to the bridge.

    sendall gets one deadline for the entire call, and the bridge drains
    at 9600 baud (~960 B/s), so reusing the 10 s connect timeout would
    truncate any page bigger than the socket buffers (~25 KB per Letter
    page). Half the drain rate for margin, plus headroom for a job ahead
    of us in the bridge's accept backlog.
    """
    return 60 + job_len / 400


def _pump_tcp(sock, job):
    """Write ``job`` to ``sock``. Always closes ``sock``.

    No flock here: the bridge accepts one client at a time and holds the
    next connection in its backlog, so jobs serialize at the printer.
    """
    try:
        sock.settimeout(_write_timeout(len(job)))
        sock.sendall(job)
    finally:
        sock.close()


def _pump_logged(pump, handle, job):
    """Thread body — no caller left to catch, so log."""
    try:
        pump(handle, job)
    except Exception:
        log.error("print failed mid-write", exc_info=True)


def _render_job(path):
    with Image.open(path) as img:
        return render_raster(img)


def print_file(path, port, baud=9600):
    """Print the image at ``path`` over ``port``, blocking until the whole
    job is written. Returns the job byte count."""
    job = _render_job(path)
    _pump(_open_serial(port, baud), job)
    return len(job)


def print_file_tcp(path, host, port=9100):
    """Print the image at ``path`` to a TCP bridge, blocking until the whole
    job is written. Returns the job byte count."""
    job = _render_job(path)
    _pump_tcp(_open_tcp(host, port), job)
    return len(job)


def start_print(path, port, baud=9600):
    """Print the image at ``path`` over ``port`` from a background thread.

    Every predictable failure — missing or corrupt image, missing port,
    unsupported baud — raises here, before the thread starts; only
    mid-write I/O errors are log-only. Returns the job byte count.
    """
    job = _render_job(path)
    fd = _open_serial(port, baud)
    threading.Thread(target=_pump_logged, args=(_pump, fd, job),
                     daemon=True).start()
    return len(job)


def start_print_tcp(path, host, port=9100):
    """Like ``start_print``, but to a TCP bridge. Bad images and connection
    failures raise here, before the thread starts."""
    job = _render_job(path)
    sock = _open_tcp(host, port)
    threading.Thread(target=_pump_logged, args=(_pump_tcp, sock, job),
                     daemon=True).start()
    return len(job)


def _test_pattern():
    """Solid bar + checkerboard + gradient — exercises solid fill, fine
    detail, and dithering on real hardware."""
    img = Image.new("L", (PRINTER_WIDTH_DOTS, 120), 255)
    img.paste(0, (0, 0, PRINTER_WIDTH_DOTS, 40))
    for y in range(40, 80):
        for x in range(PRINTER_WIDTH_DOTS):
            if (x // 8 + y // 8) % 2 == 0:
                img.putpixel((x, y), 0)
    for y in range(80, 120):
        for x in range(PRINTER_WIDTH_DOTS):
            img.putpixel((x, y), x * 255 // (PRINTER_WIDTH_DOTS - 1))
    return img


def _main():
    parser = argparse.ArgumentParser(
        description="Print an image (or a built-in test pattern) to an "
                    "ESC/POS serial or TCP thermal printer.")
    parser.add_argument("--port",
                        help="serial device, e.g. /dev/ttyUSB0 (Linux) or "
                             "/dev/cu.usbserial-XXXX (macOS)")
    parser.add_argument("--baud", type=int, default=9600)
    parser.add_argument("--host",
                        help="TCP bridge host (WiFi ATOM), e.g. "
                             "drawbox-atom.local")
    parser.add_argument("--tcp-port", type=int, default=9100)
    parser.add_argument("image", nargs="?",
                        help="image file to print (default: test pattern)")
    args = parser.parse_args()
    if bool(args.port) == bool(args.host):
        parser.error("exactly one of --port or --host is required")
    if args.image:
        if args.host:
            sent = print_file_tcp(args.image, args.host, args.tcp_port)
        else:
            sent = print_file(args.image, args.port, args.baud)
    else:
        job = render_raster(_test_pattern())
        if args.host:
            _pump_tcp(_open_tcp(args.host, args.tcp_port), job)
        else:
            _pump(_open_serial(args.port, args.baud), job)
        sent = len(job)
    print(f"sent {sent} bytes to {args.host or args.port}")


if __name__ == "__main__":
    logging.basicConfig(level=logging.INFO)
    _main()
