maximeprades/drawbox/firmware/esp32_amoled_button/gateway_ca.h

// Trust anchors for wss://ai-gateway.vercel.sh (conversation mode).
//
// ArduinoWebsockets' setInsecure() is a no-op on ESP32 (only the ESP8266
// fingerprint path honors it) and the esp32 core refuses a TLS connect
// with neither a CA nor insecure mode, so the realtime client must pin
// a root. The Gateway's certificate is issued by Let's Encrypt; every
// LE default chain terminates at ISRG Root X1 (RSA) or X2 (ECDSA), both
// below verbatim from https://letsencrypt.org/certificates/ with sha256
// fingerprints
//   X1 96:BC:EC:06:26:49:76:F3:74:60:77:9A:CF:28:C5:A7:CF:E8:A3:C0:AA:E1:1A:8F:FC:EE:05:C0:BD:DF:08:C6
//   X2 69:72:9B:8E:15:A8:6E:FC:17:7A:57:AF:B7:17:1D:FC:64:AD:D2:8C:2F:CA:8C:F1:50:7E:34:45:3C:CB:14:70
// If Vercel ever moves the Gateway to another CA the box logs
// "[rt] wss connect failed" and falls back to the one-shot flow; add
// the new root here and reflash.
#pragma once

static const char GATEWAY_CA_PEM[] PROGMEM = R"PEM(
-----BEGIN CERTIFICATE-----
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
-----END CERTIFICATE-----
-----BEGIN CERTIFICATE-----
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
/q4AaOeMSQ+2b1tbFfLn
-----END CERTIFICATE-----
)PEM";
