maximeprades/drawbox/(commit log)

2026-02-16 Initial open-source release of DrawBox
    AI-powered coloring page printer for kids. Press a button, say what you
    want to draw, get a coloring page in 30 seconds. Built with a Raspberry
    Pi 5, OpenAI APIs, a Brother laser printer, and a cardboard box with
    googly eyes.
2026-02-16 Add hero photo, update parts list, unblock poop
    - Add docs/drawbox.jpg hero image for README
    - Update parts table with actual Amazon order items (Pi 5 Budget Kit,
    active cooler, UGREEN printer cable, spade terminals, vent grille)
    - Add optional accessories note (HDMI adapter, SD card reader)
    - Remove "poop" from safety blocklist across all 5 files
2026-02-18 Add please mode, faster generation, and jokes while waiting
    - "Please" mode: optionally require kids to say "please" (EN/FR),
    togglable via ~/.drawbox/please_mode file or web dashboard
    - Switch image quality from medium to low for faster generation
    - Tell kids jokes (50 pre-vetted) via TTS while image generates
    in a background thread
2026-02-28 Switch to FLUX Schnell, fix image cropping, fix voice truncation
    - Replace gpt-image-1 with FLUX Schnell via Replicate (~1s vs 30-60s)
    - Use portrait 3:4 aspect ratio to better fill 8.5x11 paper
    - Add prompt padding to prevent subject from being cut off at edges
    - Fit image onto letter canvas preserving aspect ratio with margins
    - Prepend "... " to all voice lines to prevent USB speaker clipping
    - Add Replicate API token config to simulator and Python scripts
    [drawbox.py, drawbox_web.py]
2026-02-28 Fix voice "dot dot dot", add Replicate setup, add Pi guide
    - Replace "..." TTS prefix with silence MP3 played before each
    speech file via mpg123 multi-file support (wakes USB speaker
    without producing audible "dot dot dot")
    - Generate silence.mp3 during warmup using TTS of a comma
    - Add REPLICATE_API_TOKEN to deploy-web.sh and check.sh
    - Add startup validation for missing API keys in both scripts
    - Update README: FLUX Schnell, ~$0.02/page, ~10s cycle time
    - Add PI-SETUP.md with step-by-step SSH and deployment guide
    - Improve simulator error messages for invalid/missing API keys
    [drawbox.py, drawbox_web.py]
2026-02-28 Add API test buttons and detailed error logging to simulator
    - "Test OpenAI" / "Test Replicate" / "Test Image Generation" buttons
    let you individually verify each API endpoint
    - Wrap all fetch() calls in try/catch to distinguish network errors
    (CORS/file://) from HTTP errors (401/403/500)
    - Show specific fix suggestions: "try localhost instead of file://"
    - Log HTTP status codes, response sizes, and prediction IDs
2026-02-28 Route Replicate API through CORS proxy for browser simulator
    Replicate API blocks browser CORS, so route calls through
    corsproxy.io. This lets the simulator generate images with
    only a Replicate token — no OpenAI key needed.
    - replicateFetch() wraps fetch with corsproxy.io proxy
    - Updated test buttons to use proxy too
    - OpenAI fallback still available if proxy fails
2026-02-28 Add Nano Banana 2 (Gemini) as third image model option
    Three-model architecture: FLUX Schnell (Replicate), Nano Banana 2
    (Gemini 2.5 Flash Image), and GPT Image (OpenAI). IMAGE_MODEL env
    var selects the model, with automatic fallback chain in the simulator.
    Updated deploy/check scripts and Pi setup guide for GEMINI_API_KEY.
2026-02-28 Add gunicorn, fix Cloudflare Tunnel, update README
    - Switch web dashboard from Flask dev server to gunicorn (fixes
    Werkzeug 3.x rejecting WebSocket upgrade requests from cloudflared)
    - Fix deploy-tunnel.sh: write config/credentials to /etc/cloudflared/
    instead of ~/.cloudflared/ so systemd service finds them
    - Add ProxyFix middleware for proper reverse proxy header handling
    - Move safety mode init out of __main__ for gunicorn compatibility
    - Update deploy-web.sh to install gunicorn alongside Flask
    - Update README with image models, web dashboard features, remote
    access via Cloudflare Tunnel, hub page, and safety toggle docs
    - Update PI-SETUP.md with Cloudflare Tunnel section
    - Add SKIL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
    [drawbox_web.py]
2026-02-28 Redesign dashboard with shadcn sidebar UI, add analytics + software updates
    - Replace single-column layout with sidebar + 8-page navigation (Overview, Generate, Logs, Settings, WiFi, Diagnostics, Update, System)
    - Add usage analytics: print logging to ~/.drawbox/print_log.jsonl, GET /api/analytics with stats/charts
    - Add software update: GET /api/update/check + POST /api/update/deploy for one-click updates from browser
    - Add analytics logging to drawbox.py button prints
    - Add git repo clone step to deploy-web.sh for update support
    [drawbox.py, drawbox_web.py]
2026-02-28 Polish overview stat cards: consistent heights, shorter uptime, subtitles
    [drawbox_web.py]
2026-03-01 Fix crash loop: load API keys from dashboard config, don't exit on missing keys
    The service was crash-looping (restart counter 158+) because it only read
    API keys from env vars, missing keys set via the web dashboard. Now reads
    from ~/.drawbox/api_keys.json (same as drawbox_web.py) with env var fallback.
    Missing image model keys are warnings instead of fatal errors — the app stays
    running and only fails gracefully at generation time.
    [drawbox.py]
2026-03-01 Default to nano-banana, sync coloring prompt from dashboard, fix card alignment
    - Change default image model from flux-schnell to nano-banana in both scripts
    - drawbox.py now reads coloring prompt from ~/.drawbox/web_settings.json
    (shared with the dashboard), so editing the prompt in Settings actually
    takes effect on the Pi service
    - Fix stat cards: consistent 120px height, prevent text overflow
    - Fix analytics grid cards: equal height via flex stretch
    [drawbox.py, drawbox_web.py]
2026-03-01 Fix card alignment: remove margin-top override in grid layouts
    The .card + .card margin-top rule was applying to side-by-side cards
    in the analytics grid, pushing Popular Prompts down. Override it
    inside grid containers where gap handles spacing instead.
    [drawbox_web.py]
2026-03-01 Add verbose logging: startup config, API call timing, response details, tracebacks
    - Startup now prints full config: model, key status (first 8 chars),
    keys source file, settings file
    - Each API call (Replicate, Gemini, OpenAI, Whisper) logs timing and
    response size
    - Gemini errors log full response structure for debugging
    - Errors now print full tracebacks instead of just the message
    [drawbox.py]
2026-03-01 Fix coloring prompt textarea: remove dark code-input styling
    The code-input class was giving the textarea a dark terminal-style
    background (#18181b) making the pre-filled text invisible. Use the
    standard textarea styling instead.
    [drawbox_web.py]
2026-03-01 Fix empty coloring prompt: merge defaults with saved settings
    load_settings() was returning only saved data if the file existed,
    missing any keys added after the file was first created. Now starts
    with defaults and merges saved values on top, so the coloring prompt
    shows up even on existing installs.
    [drawbox_web.py]
2026-03-01 Fix empty prompt override: skip blank saved values when merging defaults
    The settings file had coloring_prompt="" from a previous save, which
    overrode the default. Now only non-empty saved values override defaults.
    [drawbox_web.py]
2026-03-01 Add Scripts page: editable voice lines and jokes from the dashboard
    New "Scripts" page in the web dashboard lets you customize all voice
    lines (ready, listening, thinking, printing, done, error, etc.) and
    the jokes told while generating. Saves to ~/.drawbox/voice_scripts.json.
    drawbox.py loads overrides at startup and merges with hardcoded defaults.
    Multi-line values (like "thinking") become random pick lists.
    Service restart required after changes (button shown after save).
    [drawbox.py, drawbox_web.py]
2026-03-09 Switch TTS from OpenAI to ElevenLabs with expressive voice tags
    - Replace OpenAI TTS-1 with ElevenLabs API (eleven_multilingual_v2)
    - Add ElevenLabs API key management (dashboard + drawbox_core.py)
    - Add Voice ID field, Stability and Style Exaggeration sliders to dashboard
    - Add emotion tags to voice lines ([cheerfully], [excitedly], [gently], etc.)
    - Add [giggling] + pause markers (...) before joke punchlines
    - Limit to 1 joke per session instead of looping
    - Generate silence file via ffmpeg (0.5s) instead of TTS API call
    - Clear voice cache automatically on deploy/update
    - Extract shared logic into drawbox_core.py module
    [drawbox.py, drawbox_core.py, drawbox_web.py]
2026-05-17 Add speaker and mic test buttons to Diagnostics page
    - Test Speaker: plays a 440Hz sine tone via speaker-test, output confirms it ran
    - Test Mic: records 2s via arecord, measures peak amplitude, reports pass/fail with level
    [drawbox_web.py]
2026-05-17 Fix speaker test: auto-detect USB card, bypass ~/.asoundrc, report card mismatch
    speaker-test was failing because it used the 'default' ALSA device, which relies
    on ~/.asoundrc being correct. The new /api/test/speaker endpoint detects the USB
    speaker card via aplay -l, tests directly on plughw:X,0 (no .asoundrc needed),
    and reports if ~/.asoundrc has a stale card number with the fix command.
    [drawbox_web.py]
2026-05-18 Harden web dashboard, dedupe defaults to core, add pytest suite
    Security
    - Tighten CORS: anchored host regex (default *.drawbox.pages.dev) plus
    DRAWBOX_ALLOWED_ORIGINS env var. Closes substring matches that let
    evil.drawbox.attacker.com pass.
    - Replace tempfile.mktemp with mkstemp in /api/test/mic.
    - isinstance-guard every POST body (/api/settings, /api/scripts,
    /api/keys, /api/generate, /api/wifi/connect, /api/diagnostics);
    invalid types return 400 instead of a 500 traceback.
    - Mask printed API keys to 4 chars via new mask_key().
    - Drop SSID inline-onclick (data-ssid + addEventListener) to close the
    adversarial-SSID XSS in the WiFi list.
    - SSE journalctl process now cleaned up in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
    [drawbox.py, drawbox_core.py, drawbox_web.py]
2026-05-19 Address bugbot: escape quotes in esc(), drop dead default_voice_text
    esc() previously used textContent→innerHTML which left "/' unescaped,
    allowing a crafted SSID to break out of data-ssid="..." in the WiFi list.
    Switched to a full-replace escape covering &<>"' so attribute context is safe.
    Removed default_voice_text — unused since the DEFAULT_VOICE_LINES dict landed.
    [drawbox_core.py, drawbox_web.py]
2026-05-22 Auto-detect USB mic and show last 24h of logs in dashboard
    record_audio() relied on ALSA's default input device, which on this Pi
    points to the speaker (~/.asoundrc has defaults.pcm.card 2) — that card
    has no input channels, so sd.InputStream crashed with PortAudioError
    "Error querying device -1" before any audio was captured. The Debian 13
    upgrade reshuffled card numbers and turned this latent fragility into a
    hard failure on every button press.
    The same auto-detect-by-name pattern already used for the speaker in
    check.sh is now applied to the mic in drawbox.py, in Python, so card
    reshuffles can't break it again.
    Separately, the Logs page in the dashboard only showed the live stream
    sta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
    [drawbox.py, drawbox_web.py]
2026-05-22 Address review: cap SSE backfill, harden logs download, lift mic constant
    Four issues from the post-merge audit of 4ef5658:
    - /api/logs/download could 500-with-traceback when journalctl took longer
    than 30s; now catches subprocess.TimeoutExpired and returns 504 with a
    plain-text message, matching how the rest of the file handles slow
    subprocess calls.
    - The same endpoint built Content-Disposition with a raw f-string. The
    current timestamp format can only contain safe characters, but the
    pattern is the only one in the file that constructs that header
    manually — it sets a bad precedent. Switched to Flask's send_file with
    a BytesIO so header encoding is handled correctly.
    - /ap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
    [drawbox.py, drawbox_web.py]
2026-05-25 Fix simulator poop mode wiring
2026-05-25 Avoid PortAudio calls in audio callback
    [drawbox.py]
2026-05-26 Handle TTS rate limits and missing audio inputs
    [drawbox.py]
2026-05-29 Fix saved WiFi nmcli field query
    [drawbox_web.py]
2026-05-29 Address Bugbot saved WiFi parser comments
    [drawbox_web.py]
2026-08-04 Add spoken-code device pairing and clean up TTS/WiFi internals
    Pairing: press the button and say "authorize" — DrawBox speaks a
    one-time 6-digit code (2-minute window, 5 attempts). POST /api/pair
    exchanges it for a permanent device token; a before_request guard now
    requires a token on every /api route except /api/pair and /api/status.
    The dashboard injects the token via a fetch wrapper, shows a pairing
    overlay on 401, and lists/revokes paired devices in Settings. Tokens
    are stored as sha256 hashes and compared constant-time. /api/logs
    accepts ?token= because EventSource cannot send headers.
    Cleanup from code review: ElevenLabs calls centralized in one
    _synthesize helper (rate-limit gate +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
2026-08-04 Address Bugbot pairing review comments
    - Claim the pairing window atomically (os.replace) before validating so
    one spoken code can never mint two tokens across gunicorn workers.
    - Accept ?token= on /api/logs/download too — the download link is plain
    <a> navigation and can't send an Authorization header.
    - Zero-pad typed pairing codes so "12345" matches spoken "012345".
    [drawbox_core.py, drawbox_web.py]
2026-08-10 Print pairing codes, harden update/recovery paths, add Mac app
    Pairing codes now print a Letter-size card as well as being spoken —
    the speaker died silently in production, so paper is the reliable
    channel. The voice line only claims a printout when printing actually
    succeeded, and is_pairing_command accepts Whisper's past-tense
    "authorized/authorised" transcriptions.
    The dashboard self-heals a missing template after updates performed by
    pre-templates self-updaters (tombstoned for removal once the fleet
    transitions past Aug 2026). Settings/pairing files are written with an
    atomic replace, and the pairing-card font fallback uses sized defaults
    (Pillow >= 10.1) so a missing DejaVu can't ren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
    [drawbox.py, drawbox_core.py, drawbox_web.py, main.rs]
2026-08-22 Fix Mac app update button that did nothing on click
    Tauri 2 / WKWebView never shows window.confirm() and always returns
    false, so Install Update & Restart (and every other confirm-gated
    action) bailed out with no UI. Replace native confirms with an in-page
    modal that works in the Mac app and in a browser.
    [main.rs]
2026-08-22 Clamp WiFi autoconnect priority to NetworkManager's range
    Reorder started at 1000, but nmcli only accepts [-999, 999].
    That made the up/down priority buttons fail with
    "1000 is out of range". Start the ladder at 990 and clamp
    every write.
    [drawbox_web.py]
2026-08-22 Make settings toggles flip on the whole row
    The Please / Safety / Poop knobs looked disabled when off and only
    the 44px switch accepted clicks. The Mac app also ignored a failed
    POST and snapped the knob back. The whole row is now the control,
    the knob flips immediately, and a failed save restores it with an
    error toast.
2026-08-22 Route all DrawBox inference through one AI Gateway key
    Replace the OpenAI, Replicate, Gemini, and ElevenLabs keys with a single
    AI_GATEWAY_API_KEY. Images, TTS, and Whisper now call the Vercel AI Gateway
    OpenAI-compatible API.
    [drawbox.py, drawbox_core.py, drawbox_web.py]
2026-08-22 Simplify Gateway image routes and drop leftover TTS knobs
    Use one IMAGE_ROUTES table and a single b64 image payload. Remove
    ElevenLabs stability/style settings. Catch OpenAI RateLimitError
    instead of urllib HTTPError. Render TTS voices from one Python list.
    [drawbox.py, drawbox_core.py, drawbox_web.py]
2026-08-22 feat(printer): add ESC/POS serial backend and print_image dispatch
    drawbox_escpos.py renders a PIL image into an ESC/POS raster job (trim white margins, resize to 384 dots, Floyd-Steinberg dither, banded GS v 0 blocks) and writes it to a POSIX serial port with stdlib termios. print_image() dispatches on the new printer_type setting: escpos_serial runs in a daemon thread because a page takes ~25 s at 9600 baud, while lp returns instantly after queueing. The module doubles as a hardware smoke-test CLI.
2026-08-22 feat(web): expose printer settings in the dashboard
    Settings gains a Printer card: printer type select, serial port, and baud rate. The serial fields show only for the thermal type. /api/settings validates printer_type against the two known backends and rejects non-positive baud rates through the handler's existing 400 path.
2026-08-22 feat(firmware): add ATOM Printer USB bridge sketch, health probe, and docs
    The stock ATOM Printer firmware only exposes AP/MQTT text printing, so a 20-line sketch turns it into a dumb USB serial bridge to the print head (RX=G33, TX=G23, both links 9600 so the host paces the head). check.sh probes the configured serial port instead of CUPS when printer_type is escpos_serial. README and ARCHITECTURE document the setup.
2026-08-22 Add voice provider setting with Grok (xAI) TTS support
    New voice_provider setting selects between the existing ElevenLabs
    configuration (voice ID, stability, style — unchanged, including the
    on-disk cache key format) and the xAI Grok Voice API via a new
    _grok_tts method posting to api.x.ai/v1/tts with the configurable
    grok_voice_id (default eve). The daemon now requires the key for the
    selected provider at startup, and the dashboard shows only the active
    provider's fields.
    [drawbox.py, drawbox_core.py, drawbox_web.py]
2026-08-22 fix(voice): construct VoiceFeedback with an explicit provider
    VoiceFeedback dispatched on a module global that _apply_tts_settings
    loads from the real ~/.drawbox/web_settings.json at import time. Once a
    host had saved voice_provider grok, two pre-existing tests that patch
    _elevenlabs_tts dispatched to _grok_tts instead and sent live requests
    to api.x.ai. The provider is now a constructor argument (main passes
    the settings value; tests default to elevenlabs), so dispatch never
    depends on host state. TTS_PROVIDER_KEYS maps each provider to its
    required key so the startup gate cannot drift from the dispatch, the
    duplicated transport collapses into _fetch_audio with the wake-pause
    prefix defined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
    [drawbox.py]
2026-08-22 fix(printer): surface serial print failures and lock the port across processes
    Review findings from the thermo-nuclear audit. start_print() now renders and opens the port synchronously so every predictable failure (missing port, unsupported baud, corrupt image) raises to the caller, restoring error parity with the lp path; only the ~25 s byte pump runs in a daemon thread, and mid-write errors are log-only. The process-local threading.Lock is replaced by fcntl.flock on the device fd, since the button daemon and the dashboard print from separate processes. PRINTER_TYPES and SERIAL_BAUDS now live in drawbox_core (the SUPPORTED_MODELS precedent): load_settings() normalizes invalid stored types t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
    [drawbox_core.py, drawbox_escpos.py, drawbox_web.py]
2026-08-22 fix(core): lazy-import the ESC/POS backend so partial deploys boot
    drawbox_escpos was imported at module top but only used inside
    print_image's escpos_serial branch. Deploys that copied the new
    drawbox_core.py without drawbox_escpos.py made import drawbox_core
    raise ModuleNotFoundError, killing both the button daemon and the
    dashboard at startup; every client then showed the offline screen.
    Importing inside the branch turns that state into a print-time error
    for escpos users and a non-event for everyone else.
    [drawbox_core.py]
2026-08-22 fix(deploy): glob runtime modules in both deploy paths
    The self-updater's files_to_copy list and deploy-web.sh's scp list both
    predate drawbox_escpos.py, so an Install Update shipped code importing
    a module that never reached the Pi. Both paths now glob drawbox*.py via
    _files_to_deploy, and tests pin that every runtime module in the repo
    is covered, so a new module can never be left behind by a stale list
    again.
    [drawbox_web.py]
2026-08-28 feat(web): pick the printer from the Generate page
    The Generate form now has the same CUPS / thermal dropdown as Settings.
    The choice is sent with /api/generate, used for that print, and saved
    so the two pages stay in sync.
2026-08-28 fix(web): persist printer choice when either dropdown changes
    Settings reloads from disk on every visit, so a Generate-only pick
    snapped back to CUPS. Write printer_type as soon as the user changes
    either select.
2026-08-28 fix(web): wait for printer save before reloading settings
    Settings was fetching the old type if you switched pages during the
    POST. Await the in-flight save first.
2026-08-28 fix(voice): call the gateway's v4 speech and transcription endpoints
    The AI Gateway's OpenAI-compatible /v1 surface has no audio routes: POST /v1/audio/speech and /v1/audio/transcriptions return 404 not_found_error, which silenced every TTS line and would fail transcription on the next button press. Speech and transcription actually live on the AI SDK's v4 protocol endpoints. _gateway_tts and transcribe() now POST there via a shared _gateway_v4_post helper with the protocol headers (ai-gateway-protocol-version 0.0.1, per-modality specification-version 4, ai-model-id), decode the base64 audio reply, and keep the existing HTTPError, rate-limit, and unlink-in-finally behavior. Verified against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
    [drawbox.py, drawbox_core.py]
2026-08-28 fix(images): surface the model's answer when a chat image is missing
    _image_bytes_from_chat discarded message.content on failure, so journals showed 'No image in gateway chat response' with no way to tell a refusal from a provider fault. Both raise sites now log and embed finish_reason plus a 300-char content snippet, keeping the original message prefix.
    [drawbox_core.py]
2026-08-28 feat(web): render the generated page on Generate and remember the last one
    The box keeps the newest processed PNG in ~/.drawbox/last_generated.png
    (button and web prints both). The Generate page shows the fresh result
    inline and reloads the last page every time it opens, so a lost response
    or page switch no longer hides the output.
    [drawbox_core.py, drawbox_web.py]
2026-08-28 fix(images): read gateway chat images as SDK dicts
    The OpenAI Python client keeps message.images as raw dicts. Attribute
    access then raised, and DrawBox reported a missing image on a normal
    finish_reason=stop response that already had the PNG.
    [drawbox_core.py]
2026-08-28 fix(web): finish the update reply before restarting gunicorn
    The Update page sat on "Starting deployment..." because a 1s daemon
    thread killed the web service before the browser read the JSON. Schedule
    the restart in a detached process, time out the fetch, and wait through
    the bounce before treating /api/status as the new worker.
    [drawbox_web.py]
2026-08-30 feat(printer): add escpos_tcp network printing and ATOM WiFi bridge firmware
    The M5Stack ATOM Printer can now be a network printer: new
    firmware/atom_printer_bridge_wifi joins WLAN, announces
    drawbox-atom.local via mDNS, and pipes one TCP client (port 9100) to
    the print head. Pi side gains the escpos_tcp printer type (drawbox_core
    dispatch, drawbox_escpos socket output and --host CLI, web settings
    validation, dashboard fields). Includes WiFi failure diagnostics
    (disconnect reasons, scan on stall) and TCP path tests.
    [atom_printer_bridge_wifi.ino, drawbox_core.py, drawbox_escpos.py, drawbox_web.py]
2026-08-30 fix(web): stop dead log streams from pinning gunicorn threads
    journalctl -f never ends and a vanished SSE client is only noticed when
    a write fails, so on a quiet journal each abandoned /api/logs stream
    held a worker thread forever; four of them saturated gunicorn and froze
    the dashboard (2026-08-30). The stream now emits a keepalive comment
    every 15s so dead clients fail fast, and the dashboard only opens the
    stream while the Logs page is visible instead of on every page load.
    [drawbox_web.py]
2026-08-30 fix(web): make the working thermal option obvious and surface print errors
    The serial option's label named "M5Stack ATOM", so users picked it on
    boxes where the ATOM is a WiFi printer, hit the missing /dev/ttyUSB0,
    and silently persisted the broken choice as their default. The WiFi
    option now leads with the product name and a recommendation, serial is
    labeled as the cable path. A print failure after a successful
    generation also now reports its actual reason instead of the generic
    "Generation failed", and still returns the image.
    [drawbox_web.py]
2026-08-30 fix(printer): size TCP write deadline to the job; harden bridge and dashboard
    Thermo review follow-ups. The big one: sendall gets a single deadline
    (PEP 475) and the bridge drains at ~960 B/s, so the 10s connect timeout
    reused as the write timeout would truncate any page larger than the
    socket buffers — silently, after the dashboard reported success. The
    write deadline now scales with job size.
    Firmware: a half-open client (peer died without FIN) held the single
    TCP slot until power-cycle — 60s idle cutoff added, client-close
    handling reworked (the old close branch was dead code), boot-failure
    scan no longer fires on later transient drops, USB forwarding pauses
    during TCP jobs so raster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
    [atom_printer_bridge_wifi.ino, drawbox_escpos.py, drawbox_web.py]
2026-08-30 feat(voice-button): ESP32-S3 AMOLED one-button remote + /api/voice/generate
    New firmware for the Waveshare ESP32-S3-Touch-AMOLED-2.16: tap the big
    on-screen button, speak, and the box records 16 kHz WAV and POSTs it to
    the dashboard with a paired-device token. The server grows a
    /api/voice/generate route that transcribes via the gateway Whisper path
    and reuses the exact generate/print pipeline, now extracted so both
    routes share one source of truth. drawbox.py is untouched.
2026-08-30 fix(voice): app-wide body-size backstop for chunked uploads; clamp record_seconds to the box's buffer (Bugbot)
    [drawbox_web.py, esp32_amoled_button.ino]
2026-08-30 feat(voice-button): smiley-face UI with listening animations; 2cm tear-off gap between prints
    The on-screen button is now a big friendly face: it blinks and glances
    around while idle, opens its mouth with the kid's voice while recording
    (with rippling sound waves and a progress ring), naps under an orbiting
    spinner while the Pi draws, and celebrates or apologizes with the result.
    Replaces the stacked drawCircle rim that rendered as stray black lines.
    Thermal jobs now end with an explicit ESC J 160-dot feed (~2 cm) so
    pages tear off cleanly instead of smudging into the next drawing.
    [drawbox_escpos.py, esp32_amoled_button.ino]
2026-08-30 fix(voice-button): size the mouth wipe for the widest mouth shape, not just the open ellipse (Bugbot)
    [esp32_amoled_button.ino]
2026-08-30 fix(voice-button): deepen I2S DMA so animation can't starve the mic; reject quiet takes on-device
    The face animation blocks the record loop for tens of ms per frame and
    the vendor's 8x64 DMA buffer overflowed, stretching 8 s of audio over
    12 s of wall clock and chopping the speech. Whisper then hallucinated
    text from the gaps (it invented Japanese from an empty room and DrawBox
    printed it). Six 1024-frame buffers give ~190 ms of cushion, and
    recordings peaking under 550 now show "I didn't hear anything" locally
    instead of being uploaded at all.
    [esp32_amoled_button.ino]
2026-08-30 test(escpos): expect the tear-off gap as blank raster rows, not ESC J (fails: head ignores ESC J, drawing bottoms get cut)
2026-08-30 fix(escpos): feed the tear-off gap as blank raster rows; the ATOM head ignores ESC J
    The 2cm gap shipped as ESC J 160, which this clone head silently
    drops: drawing bottoms stayed between the print head and the tear bar,
    tearing cut them off, and the missing strip emerged at the start of
    the next job. Blank raster rows are executed by anything that prints
    images, so the gap now rides inside the raster data itself.
    [drawbox_escpos.py]
2026-08-31 feat(voice-button): LVGL UI with pre-rendered emoji face
    The runtime-drawn face rendered with banding and stray lines (Arduino_GFX
    arc primitives on this panel). The UI now runs on LVGL 8.4 with the
    vendor's proven glue for this board, and the face is pre-rendered on the
    host (gen_face_assets.py, Pillow, 3x supersampled) into anti-aliased
    bitmap frames: gradient disc, glossy highlight, sparkle pupils, blush,
    seven mouth shapes. The firmware only swaps frames, so no vector face
    drawing happens at runtime. Text is Montserrat instead of the 6x8 GFX
    font, and a new serial 'p' hook dumps live screenshots for verification.
    [esp32_amoled_button.ino, gen_face_assets.py]
2026-08-31 fix(voice-button): accept serial press during result, dedicated dismiss flag, blink can't stomp other faces (Bugbot)
    [esp32_amoled_button.ino]
2026-08-31 feat(voice-button): speaker chirps via the ES8311 on the shared duplex I2S bus
    The box now sounds like a buddy: a rising cue when it starts listening
    (finishing before the mic opens so the quiet gate stays honest), a major
    arpeggio on success, a descending womp on errors, and a soft hello when
    it comes online. The ES8311 driver is vendored from the vendor example;
    its DAC power-up hides inside es8311_microphone_config, which cost one
    debugging round of silence. A serial 'b' loopback self-test plays a tone
    and reports what the mics heard.
    [esp32_amoled_button.ino, pin_config.h]
2026-08-31 feat(voice-button): speak the Pi box's own voice lines and jokes
    The box prefetches every dashboard voice line (and thinking variants)
    as 16 kHz WAV into a PSRAM cache at boot, plays them at the exact same
    moments the Pi daemon speaks (ready, listening, thinking, one joke
    while generation runs, printing, and the voice_key the server names on
    failures), and falls back to the old chirps only when a line is
    missing. One mDNS resolve per boot instead of one per fetch, and the
    prefetch retries from idle: weak WiFi previously turned one silent
    failure into a chirps-only boot.
    [esp32_amoled_button.ino]
2026-08-31 fix(voice): refresh API keys in synthesize_speech like the other network calls; clamp thinking prefetch to cache capacity (Bugbot)
    [drawbox_core.py, esp32_amoled_button.ino]
2026-08-31 chore: security hardening, docs for the two-box era, cleanup
    Security (from an agentic audit; verdict was ship-with-fixes):
    - /api/pair gets a per-IP hourly budget checked before the pairing
    window file is touched, so an anonymous flood can't burn the global
    5-attempt budget out from under the household (verified lockout).
    - /api/status caches its payload for 5s and puts a timeout + guard on
    the systemctl call: it is public and forked four processes per
    request, one of which could hang a worker forever.
    - serial_port must be a /dev path; the print path opens it O_RDWR.
    - /api/logs streams capped at two concurrent (slot released inside the
    generator, where a never-started generator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
    [drawbox_core.py, drawbox_web.py, esp32_amoled_button.ino, gen_face_assets.py]
2026-08-31 fix(security): key pair throttle on the TCP peer not spoofable XFF; stamp status cache post-probe; log slot can't leak on spawn failure (Bugbot)
    [drawbox_web.py]
2026-08-31 feat(admin): the dashboard manages both boxes
    The ESP32 box heartbeats every 60s (firmware version, WiFi RSSI, heap,
    PSRAM, voice-cache state) to a new authed endpoint; the dashboard's
    Overview page gains a Devices card showing the Pi and every paired box
    with online status and live stats, and Settings gains an ESP32 Box card
    whose speaker-volume and screen-brightness sliders the box applies on
    its next heartbeat — no reflash needed. Paired-device rows now show
    last-seen. The heartbeat response also carries record_seconds, so the
    recording window follows the dashboard live instead of boot-only.
2026-08-31 fix(admin): file-backed device status; heartbeat during generation; device deletion in the UI
    Bugbot on #38: the in-memory status dict split across gunicorn's two
    workers, flipping devices online/offline per request — status now lives
    in ~/.drawbox/device_status.json with the same atomic writes as every
    other shared file (a regression test pins the endpoint crash that a
    shadowed local caused with mixed online/offline lists). The box also
    heartbeats once when generation starts, so a long generate can't make a
    busy box read as offline.
    Devices are deletable from both the Overview Devices card and the
    Paired Devices card: same confirm flow, the caller's own entry is
    badged "this browser" and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
    [drawbox_core.py, drawbox_web.py, esp32_amoled_button.ino]
2026-08-31 feat(conversation): VAD early-stop, personalized acks, xAI STT, and opt-in Grok Voice Agent mode across both boxes
    Also fixes four latent bugs found in the audit: the button daemon now
    obeys the dashboard's image_model and record_seconds settings, gained the
    ESP32's anti-hallucination silence gate, and the ESP32 finally consumes
    the voice cache_hash (script edits reach it within one heartbeat instead
    of at reboot).
    The one-shot flow: recording ends ~1.5s after the kid stops talking
    (same thresholds both boxes); a fast-LLM acknowledgment ("Ooh, a purple
    dinosaur!") plays in the configured voice while the image generates,
    via a new two-phase ESP32 flow (firmware v1.6.0: ack clip + result
    long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
    [drawbox.py, drawbox_core.py, drawbox_realtime.py, drawbox_web.py, esp32_amoled_button.ino, realtime_spike.h]
2026-08-31 fix(conversation): address all five Bugbot findings on PR #39
    Realtime client: persistent mic/recv tasks so a cancelled ws.recv can
    never drop tool calls or transcripts; a blocklist hit on the kid's words
    now also kills the in-flight response's remaining audio; an error before
    session.updated marks the config rejected and falls back to one-shot,
    while post-config errors stay recoverable per the docs. A session that
    ran and then died mid-chat no longer cascades into the one-shot
    "I'm listening!" — the box speaks the error line instead.
    Web: the two-phase busy check reads the on-disk job slot (with a 180s
    staleness window), so the other gunicorn worker or a second box cannot
    clobber an in-f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
    [drawbox.py, drawbox_realtime.py, drawbox_web.py]
2026-08-31 docs: runbook precondition — re-check Bugbot on PR #39 before merging
2026-08-31 fix(conversation): claim the voice job slot before ack synthesis; speak via executor in realtime sessions
    Bugbot round 2: the seconds-long ack LLM+TTS ran before the running-job
    claim, so a concurrent box could clobber the slot; and blocking mpg123
    playback inside async handlers froze the websocket event loop (pings,
    frame buffering) for the clip duration. The pump still awaits speech so
    audio ordering after a moderation kill is preserved. Third finding
    (natural_ack false not persisting) was a false positive: False == 0
    keeps it through the loader, pinned by the existing round-trip test.
    [drawbox_realtime.py, drawbox_web.py]
2026-08-31 fix(review): thermo audit round — websockets>=14 floor, gate-chain consolidation, ack timeout, transcript dedup, endpoint gating
    The big one: websockets>=12 was the wrong floor — connect(additional_headers=)
    needs the >=14 asyncio client, and Bookworm's apt 10.4 imports fine, so
    deploy-web.sh's import check would have left conversation mode silently
    dead on every Pi. Requirements pinned >=14 and the deploy now checks the
    version, not importability.
    Also: the poop→blocklist ordering invariant now lives once in
    content_block() (was three copies across _rejection_error,
    execute_draw_tool, intercept_transcript); the ack LLM call fails fast
    (8s, no retries) instead of inheriting the client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
    [drawbox_core.py, drawbox_realtime.py, drawbox_web.py]
2026-09-09 fix dashboard devices and route all AI through the Gateway
    Mark a just-paired browser (Playroom) online instead of never-seen, and
    let paired devices be renamed. Stop the settings toggle hover from
    shifting the row. Drop image presets and the extra ElevenLabs/xAI key
    fields so images, Grok TTS/STT, and conversation mode all use one
    AI Gateway key and catalog model ids.
    [drawbox.py, drawbox_core.py, drawbox_realtime.py, drawbox_web.py]
2026-09-10 fix(gateway): xAI models live under spacexai/ on the AI Gateway
    The catalog lists grok-tts, grok-stt and grok-voice-think-fast-2.0 under
    the spacexai/ creator (same as the grok-imagine image ids already in
    GATEWAY_IMAGE_CATALOG). xai/... is not an id there, so Grok TTS/STT
    would have bounced off the Gateway.
    [drawbox_core.py]
2026-09-10 feat(conversation): speak the Gateway's normalized realtime protocol
    The Pi client and the shared session config still used xAI's OpenAI-clone
    wire format (session.update, response.audio.delta, Authorization header,
    /v1/realtime-model). The Gateway is an identity codec over the AI SDK's
    normalized realtime events, so:
    - realtime_session_config() emits RealtimeModelV4SessionConfig fields
    (turnDetection/server-vad, camelCase, explicit pcm16@24k both ways,
    input+output transcription on for the interceptor and moderation kill)
    - AgentSession handles session-updated, speech-started,
    input-transcription-completed, response-created, audio-delta,
    audio-transcript-delta/text-delta, function-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
2026-09-10 Server: conversation_mode in heartbeat, protocol_header, /api/agent/moderate for the ESP32 client
2026-09-10 ESP32 firmware 2.0.0: conversation-mode client over the AI Gateway realtime route
    realtime_client.h runs the live Grok Voice Agent session on the box
    (mirrors drawbox_realtime.AgentSession): mic streaming with 16k->24k
    resampling, audio-delta playback through a PSRAM ring, intercept /
    moderate / draw over the Pi's API, strikes, idle and cap timeouts, long
    press to stop. Pins the Let's Encrypt roots (gateway_ca.h): the
    library's setInsecure() is a no-op on ESP32, and the __has_include guard
    was silently compiling the spike out, so both headers now include
    ArduinoWebsockets unconditionally. Compiled with arduino-cli; not yet
    run on hardware (see HARDWARE-TODO 7b).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
2026-09-10 Make the agent prompt conversational; VAD silence 900 -> 700 ms
    DEFAULT_AGENT_INSTRUCTIONS now reads like a spoken conversation: short
    turns, one idea per turn, one playful follow-up for one-word answers, at
    most two questions before drawing, never a menu or a lecture. The tool
    description tells the agent to relay the tool's message in its own words
    and never to claim a drawing started unless the tool said so.
    AGENT_SILENCE_MS drops to 700 so the agent answers sooner after the kid
    stops talking; 900 felt like a walkie-talkie.
    [drawbox_core.py]
2026-09-10 ESP32 realtime: exact rational resampler phase
    The Q16 step truncated 16000/24000 to 43690/65536, so 960 mic samples
    became 1441 instead of 1440 and the phase drifted over a session. The
    phase is now an exact fraction reduced by the gcd (2/3 for 16k<->24k):
    960 in -> 1440 out, 2400 in -> 1600 out, no drift.
    Verified with a host harness (g++ + ASan/UBSan) that compiles this
    header against fakes for I2S, WiFiClient, LVGL and the websocket client
    and feeds it real Flask reply bodies: 111 checks pass.
    [realtime_client.h]
2026-10-04 fix(voice): rescan audio devices when no mic stream opens
    PortAudio lists devices once, at init. A USB mic plugged in after the
    button daemon started stayed invisible, so every press failed within a
    millisecond ("no usable input devices found") and the box said "I didn't
    catch that". record_audio now rebuilds the device list once when no
    input stream opens, then retries. A quiet take, or a failure on a stream
    that did open, never retries: each try costs a full listening window.
    Each take now logs its peak level, and PI-SETUP.md documents the mic
    gain (8 of 16) that the shared speech thresholds need.
    [drawbox.py]
2026-10-04 docs(readme): troubleshoot "I didn't catch that" and prints that never come out
2026-11-05 fix(print): re-enable a paused CUPS queue instead of printing into the void
    With the default error policy, one failed job (printer off, USB out)
    pauses the drawbox-printer queue for good. lp still accepts every later
    job, so the box said "Here it comes!" and no paper came out. print_image
    now checks lpstat first: a paused queue gets its stuck jobs dropped and
    is re-enabled; if cupsenable fails, it raises an OSError naming the fix,
    so the box says the error line instead of claiming success.
2026-11-05 fix(generate): cap image requests at 100 s, no retry
    Image calls used the OpenAI client defaults: 600 s timeout and two
    retries. A stalled Gateway request left the box silent for up to half an
    hour after "Drawing it now!". 100 s fits real pages (10-60 s) and stays
    under gunicorn's 120 s worker timeout on the web path.
