maximeprades/drawbox/docs/3.jpeg

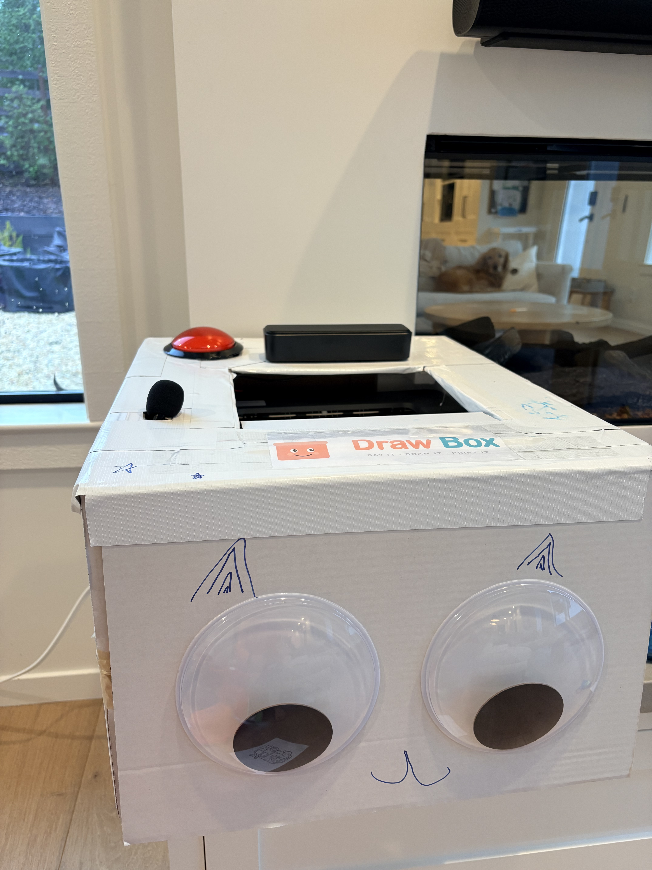
[picture p2: docs/3.jpeg]
docs/3.jpeg
