maximeprades/drawbox/docs/2.jpeg

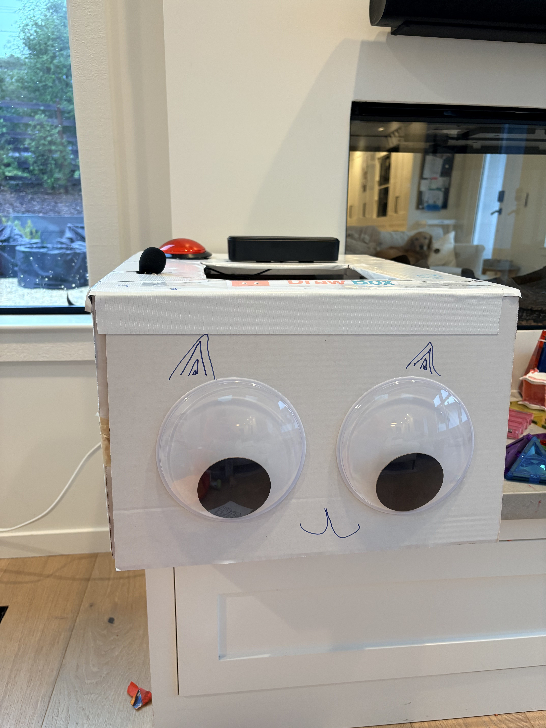
[picture p3: docs/2.jpeg]
docs/2.jpeg
